geolink/opentracker/docs/OpenTracker 2 - Light Pipe Installation.pdf

# OpenTracker 2

# Light Pipe Installation

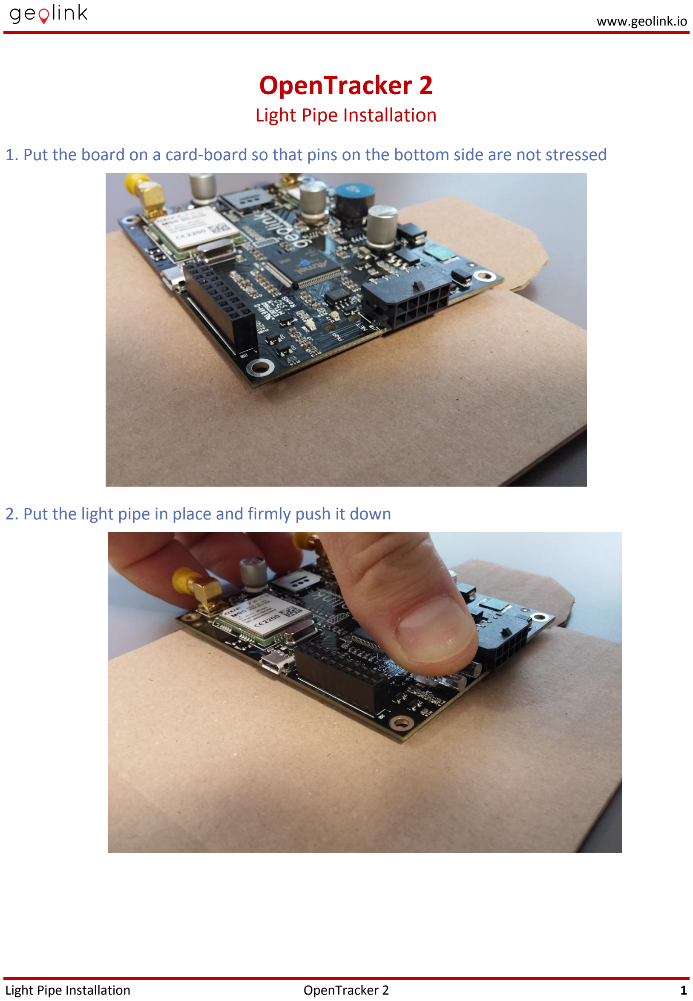
[picture p70: page 1]

### www.geolink.io

Light Pipe Installation | OpenTracker 2 | 1

## 1. Put the board on a card-board so that pins on the bottom side are not stressed

## 2. Put the light pipe in place and firmly push it down

### www.geolink.io

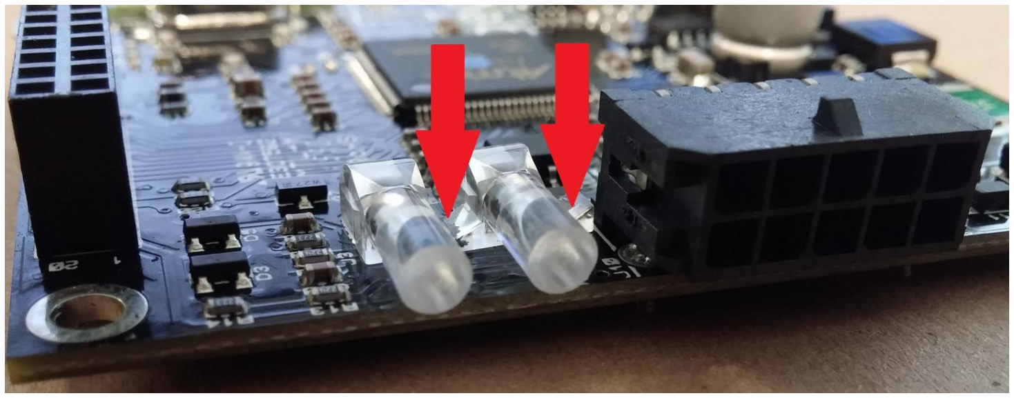
[picture p71: figure]
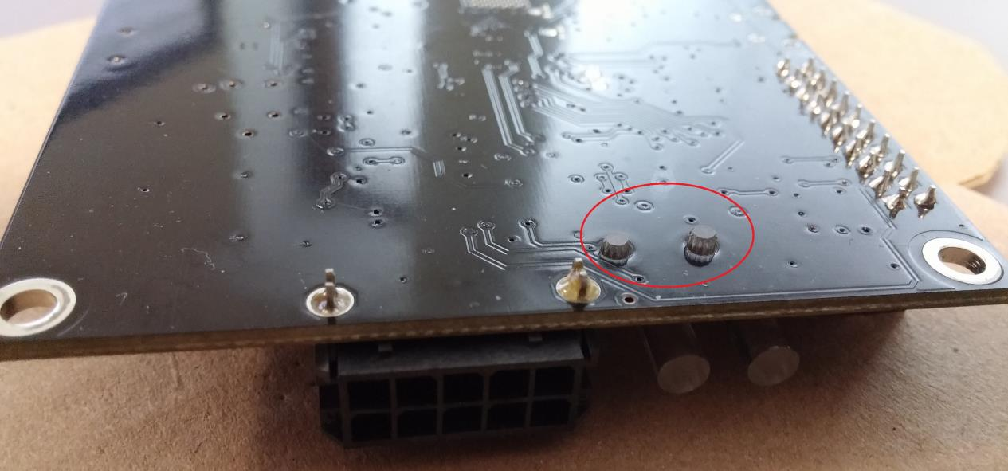
[picture p72: figure]
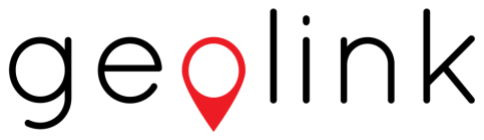
[picture p73: figure]

2 | OpenTracker 2 | Light Pipe Installation
3. If the light pipe is still not in place after pushing with a finger, you can carefully use a flat screwdriver or similar tool to push in correspondence of the small cylinders of the light pipe

## (see red arrows here below)

4. The small cylinders of the light pipe should appear as follows on the bottom side of the

## board

© Geolink all right reserved.

Geolink assumes no responsibility for any errors, which may appear in this manual. Furthermore, Geolink reserves the right to alter the hardware, software, and/or specifications detailed herein at any time without notice, and does not make any commitment to update the information contained herein. Geolink products are not authorized for use as critical components in life support devices or systems. OpenTracker is an open source development board for vehicle tracking applications and any kind of certification/homologation for a final product based on this board is responsibility of the final developer/manufacturer.
