geolink/opentracker/(threads)

Thread 1 (2015-04-20):

Update the PCB fiels and schematics

AnandSingh, 2015-04-20:
Hi

Please update the PCB files and schematics for Opentracker v2 board.

In v2 board the J2 connector is of 20 pins while in schematic and PCB it's showing 22 pins. Please update it's very tough to track the pinouts. I am looking for an uart (EXT_TX , EXT_RX) pin from J2.

Also can you update the old github  https://github.com/TIGAL/OpenTracker repository README for new location of github repository.

Thanks
Anand

AnandSingh, 2015-04-21:
HI
Can anyone help me to setup the EXT_TXD2 , EXT_RXD2.

While using Serial3 for EXT_TXD2, EXT_RXD2 i am only able to receive, but transmit EXT_TXD2 is not working. When I check the voltage level at EXT_TXD2 it's showing ~.97V.

Do I need to connect IO_TO_EXT to 3.3V with EXT_TXD2. Please suggest or help me in this regard.

Thanks
Anand

m4rkw, 2015-07-23:
Hi @AnandSingh I wish I could help but I think you'll need the geolink guys to help you with this.  I think they're swamped with emails but hopefully they'll be able to get back to you at some point.

ppescher, 2015-12-14:
Design files are up-to-date with HW revision 2.2

Closed 2015-12-14.

Thread 3 (2015-05-03):

rooming costs

haegar66, 2015-05-03:
I live near to a country border.
The cost of GPRS are very expensive by international rooming.
I want to turn off the default rooming of the data connection and activate only with an SMS command again (eg in case of theft).
Can this be installed?
greeting
Claus

m4rkw, 2015-07-08:
It should be possible, but probably not easy to implement.  I think what you probably want to do is save the network code for your home network and then detect when it changes, but that's going to involve additional queries to the modem in the main loop.  Also difficult to test as you'd have to roam in order to check that it works.  I'll add it to my someday maybe list :)

m4rkw, 2015-07-18:
@haegar66 Hi, I've just added two new SMS commands which allow you to enable and disable the sending of the data packets.  These are "dataoff" and "dataon".  In both cases it will confirm that the change has been made via sms.  While in "dataoff" mode it will still poll for its location via GPS so you can still use the sms command "locate" to see where the tracker is.  Also be sure to set GSM_SEND_FAILURES_REBOOT to 0 therwise a reboot may occur which will re-enable the data sending.  Also note that if the device gets power cycled for any reason this will also occur.

Hope this helps :)  Mark

haegar66, 2015-08-01:
Am 18.07.2015 um 17:10 schrieb Mark Wadham:
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

Hi,

I have found the solution in theory.

AT+CREG Network Registration
Parameter
0 Disable network registration unsolicited result code
1 Enable network registration unsolicited result code +CREG:
2 Enable network registration unsolicited result code with location
information
0 Not registered, ME is not currently searching a new operator to
register to
1 Registered, home network
2 Not registered, but ME is currently searching a new operator to
register to
3 Registration denied
4 Unknown
5 Registered, roaming

so it could be implemitiert:

tracker.h

   int ROAMING_ON = 0;   //Roaming 0=off 1=on

#define E-Plus_de
//  #define Vodafone_de
//  #define t-mobile_de
//  #define O2_de
//  #define Orange_at
//  #define A1_Mobilkom_Austria_at
//  #define Drei_at
//  #define t-mobile_at
//  #define Bob_at

#ifdef Drei_at
   #define DEFAULT_APN "orange.web"  //default APN
   #define DEFAULT_USER "drei.at"  //default APN user
   #define DEFAULT_PASS ""  //default APN pass
#endif

#ifdef Orange_at
   #define DEFAULT_APN "orange.web"  //default APN
   #define DEFAULT_USER "web"  //default APN user
   #define DEFAULT_PASS "web"  //default APN pass
#endif

#ifdef A1_Mobilkom_Austria_at
   #define DEFAULT_APN "orange.web"  //default APN
   #define DEFAULT_USER "web"  //default APN user
   #define DEFAULT_PASS "web"  //default APN pass
#endif

#ifdef t-mobile_at
   #define DEFAULT_APN "gprsinternet"  //default APN
   #define DEFAULT_USER "t-mobile"  //default APN user
   #define DEFAULT_PASS "tm"  //default APN pass
#endif

#ifdef Bob_at
   #define DEFAULT_APN "bob.at"  //default APN
   #define DEFAULT_USER "data@bob.at"  //default APN user
   #define DEFAULT_PASS "ppp"  //default APN pass
#endif

#ifdef Vodafone_de
   #define DEFAULT_APN "web.vodafone.de"  //default APN
   #define DEFAULT_USER "vodafone"  //default APN user
   #define DEFAULT_PASS "vodafone"  //default APN pass
#endif

#ifdef t-mobile_de
   #define DEFAULT_APN "internet.t-mobile"  //default APN
   #define DEFAULT_USER "tm"  //default APN user
   #define DEFAULT_PASS "tm"  //default APN pass
#endif

#ifdef E-Plus_de
   #define DEFAULT_APN "internet.eplus.de"  //default APN
   #define DEFAULT_USER "eplus"  //default APN user
   #define DEFAULT_PASS "eplus"  //default APN pass
#endif

#ifdef O2_de
   #define DEFAULT_APN "wap.viaginterkorn.de"  //default APN
   #define DEFAULT_USER ""  //default APN user
   #define DEFAULT_PASS ""  //default APN pass
#endif

gsm.ino

void gsm_status_read()
{
   // gsm status

   // 0 Disable network registration unsolicited result code
   // 1 Enable network registration unsolicited result code +CREG: <stat>
   // 2 Enable network registration unsolicited result code with
location information

   // 0 Not registered, ME is not currently searching a new operator to
register to
   // 1 Registered, home network
   // 2 Not registered, but ME is currently searching a new operator to
register to
   // 3 Registration denied
   // 4 Unknown
   // 5 Registered, roaming

   char *status_str;
   int auswahl = 0;

   char *tmp1;
   char *tmp1val;

   debug_print(F("gsm_status() started."));

   //todo check
   gsm_port.print("AT+CREG?");
   gsm_port.print("\r");

   delay(500);
   gsm_get_reply(0);

   //todo check if everything is delivered
   tmp1 = strstr(modem_reply, "AT+CREG: ");
   tmp1 += strlen("+CREG: ");
   tmp1val = strtok(tmp1, "\r");

   //checking how many bytes NON-acked
   status_str = strtok_r(tmp1val, ", ", &tmp1val);
   auswahl = atoi(status_str);

   switch (auswahl) {
     case 0:
       debug_print(F("Disable network registration unsolicited result
code"));
       break;
     case 1:
       debug_print(F("Enable network registration unsolicited result
code +CREG: <stat>"));
       break;
     case 2:
       debug_print(F("Enable network registration unsolicited result
code with location information"));
     default:
       debug_print(F("ERROR"));
   };

   status_str = strtok_r(NULL, ", ", &tmp1val);
   auswahl = atoi(status_str);
   switch (auswahl) {
     case 0:
       debug_print(F("Not registered, ME is not currently searching a
new operator to register to"));
       break;
     case 1:
       debug_print(F("Registered, home network"));
       gsm_status.at_home = 1;
       gsm_status.at_roaming = 0;
       break;
     case 2:
       debug_print(F("Not registered, but ME is currently searching a
new operator to register to"));
     case 3:
       debug_print(F("Registration denied"));
     case 4:
       debug_print(F("Unknown"));
     case 5:
       debug_print(F("Registered, roaming"));
       gsm_status.at_home = 0;
       gsm_status.at_roaming = 1;
     default:
       debug_print(F("ERROR"));
   };

   debug_print(F("gsm_validate_tcp() completed."));

}

sms.ino
tmp = strstr(cmd, "roaming");
      if (tmp!=NULL)
          {
            debug_print(F("sms_cmd_run(): Roaming command detected"));
            if (!ROAMING_ON)
            {
               sms_send_msg("Roaming ON", phone);
               SEND_DATA = 1;
               ROAMING_ON = 1;
            }
            else
             {  sms_send_msg("Roaming OFF", phone);
               SEND_DATA = 1;
               ROAMING_ON = 0;
             }
          }

opentracker_3_0_1.ino

   //gsm status
struct gsm_status_struct {
   int at_home;   //flag for Registered, home network
   int at_roaming; //Flag for Registered, roaming
};

gsm_status_struct gsm_status;

  debug_print(F("Current:"));
    debug_print(data_current);

  gsm_status_read(); // Roaming?

if ((SEND_DATA & gsm_status.at_home ) || (SEND_DATA &
gsm_status.at_roaming & ROAMING_ON)) {
        int i = gsm_send_data();

        if(i != 1)
        {
       //current data not sent, save to sd card
           debug_print(F("Can not send data, saving to flash memory"));
/*
        #ifdef STORAGE
           storage_save_current();   //in case this fails - data is lost
        #endif

*/

Claus Dickert

dimetron, 2015-08-12:
Hi,

Is anyone going to merge above roaming to master or I can do it?

I suggest also to have different GPS timeouts to be set in roaming and potentially
use RAW TCP with compression of several points using polylinealgorithm  https://developers.google.com/maps/documentation/utilities/polylinealgorithm?hl=en

agraciabona, 2016-01-26:
Hi,
I have the opposite problem than haegar66.
I want my tracker contiues working even out of my country but actually does not.
Maybe it is because I modified tracker.h as follows:

#define DEFAULT_APN "orangeworld"
#define DEFAULT_USER "orange"
#define DEFAULT_PASS "orange"

I made this because it is the APN I want to use and my SIM card does not allow SMS (it is cheaper!).

My question is: if I use default settings:

#define DEFAULT_APN "internet"
#define DEFAULT_USER ""
#define DEFAULT_PASS ""

my tracker will connect in every coutry?

I am far away from any border and it's difficult for my to test.
I'll be happy if someone can answer me.

Thanks
Alfredo

bullshit, 2016-01-27:
Hi Alfredo,

if think that your mobile operator blocks GPRS connections outside your country. The APN connections are always the same. This issue treated the possibility to turn off GPRS communication in foreign countries because GPRS roaming is mostly expensive.
>I want to turn off the default roaming of the data connection and activate only with an SMS command again

m4rkw, 2016-01-27:
FWIW I had the same issue using giffgaff in the uk.  Drove to france, tracker mysteriously stopped working.  I think I checked that roaming was enabled on my account before we went, but not 100% sure.  Might go back again sometime this year so if I do I'll check it again and try to figure out why it wasn't working.

agraciabona, 2016-01-27:
I think APN are not allways the same, in Spain APN for Orange is "orangeworld" in France it is "orange". When my vehicle went to France it stopped connecting. I have roaming activated in my SIM card.
I dont know how mobile phones do to switch APN when they travel to other country. I would like to do the same or maybe there is a generic APN which works in every country... if someone can help me...

m4rkw, 2016-01-27:
Maybe there's a mechanism for pushing out APN updates when you roam, that mobile phones are programmed to handle but opentracker is not.  Just a theory.

agraciabona, 2016-01-29:
Please haegar66, maybe you can help me: which APN do you use that provokes your opentracker roam?

agraciabona, 2016-05-13:
Hi,
I want my tracker roams but it doesnt: when it gets out of Spain it stops transmiting.
Anyone can tell which APN should be used to make it roam???
Thanks

ZdenekAster, 2016-05-13:
In Czech Republic GSM operators, APN is some at roaming. But some operators in roaming, send html page with text and button to accept roaming data connect.... Without this click to button roaming not working :-(

m4rkw, 2016-05-14:
@agraciabona I haven't managed to get mine working with roaming yet either, probably because like you say the APN changes.  I think with the current software the only way to get it to work would be to put the sim card into a modern mobile phone, see what the APN gets automatically set to and then configured that in the tracker.

Daniel-dk, 2016-07-18:
you could look at services like Jasper wireles or telit - They are "international network providers

 - they are a bit more expensive than regular operators but have the same APN and manage the roaming for you so the device does not need separate settings per country
We've used Telit before and it worked great ( sub-Saharan Africa )- They need to know how many devices and which countries you want to roam in to give you pricing, so it a bit of a pain, but can provide up to 3 test SIMS.

 - [JASPER wireless ( now Cisco )](https://www.jasper.com/)
 - [Telit ( I think they use Jasper in the background )](http://www.telit.com/products-and-services/iot-connectivity/sim-cards-data-plans/)

Thread 13 (2015-06-26):

imei=D

Fyod, 2015-06-26:
Hi!
I'm testing this library with my Quectel device and unfortunately I always get imei=D.
If I write a program that only shows the imei in the loop, it shows the correct imei every time.
What could be wrong?

Also it seems to me that I'm not getting the GSM date/time because it shows modem reply /[....data....]. Although in debug console I can see the correct GSM date/time a little bit after startup.

I can't use the DueStorage library because the device isn't Due compatible. Is there an alternative to this?

On my server:
imei ... D
key ... testkey
data ... *blank*

Thanks!

Fyod, 2015-06-26:
Dubug:

gsm_get_imei() started
Modem Reply:
AT+GSN

Modem Reply:
865733020106159

Modem Reply:

Modem Reply:
OK

gsm_get_imei() result:
*
gsm_get_imei() completed
setup() completed

TonyArmitstead, 2015-06-29:
IMO the code is currently broken for reading time/date and IMEI from the modem. I had exactly the same problem as you did, but this was just one of many problems the code has. I am currently working through the code re-writing and fixing what _I_ perceive as defects. I currently have a 'working' unit that is reporting position to geolink.io but there are still many other problems to fix and other features _I_ want to add. I am not ready yet to share my changes but can guide you on how to fix the above problem if you are willing to make changes to the code you have.

Neville77, 2015-06-29:
I also have a device which polls quite well to geolink.io but we are trying  to get it send the data to our own server. We are getting a connection to our server but are struggling to get it to send the actual data string to the server. I am interested  in your work  Tony as we wish to add more features  to this if it is reliable code, and we are able to aquire more hardware.

TonyArmitstead, 2015-06-29:
Yes - I also had this problem as well. I changed the code to build a complete HTTP POST message as a single buffer and send it as a single transaction - instead of using the packet chunking code that was already there. This now sends the data fine but there are clear issues of max packet length (which is ok for now) and there are still some timeouts waiting for responses from the modem - still to fix those.

Fyod, 2015-06-29:
Hi Tony,
Thanks for your reply.
I have gotten the data between brackets to send, but as you confirmed, imei and time/date isn't passed on.
It would be great if you could give us some hints to get these sent.

Cheers!

TonyArmitstead, 2015-06-29:
I have created a fork of this project and uploaded all my changes to it.
https://github.com/TonyArmitstead/opentracker.git
You are welcome to clone or just take a look.
NOTE: I am nowhere near finished making my changes yet - dont expect a working system from this repository - yet.

m4rkw, 2015-07-08:
FWIW the original bug of this thread is fixed in master now.  Tony - what other issues are you having?  Let me know and I'll investigate.

m4rkw, 2015-07-08:
Oh also the gps time parsing code should be fixed now too (someone else submitted a patch).  Funny I noticed ages ago that the timestamps from the gps looked a bit weird, didn't even occur to me that the code might be broken.. I just take the timestamp from the server anyway so wasn't really too bothered.

m4rkw, 2015-07-08:
Tried to read your forked commit but so many of the changes are just formatting so it's a bit hard to see the code diffs..

TonyArmitstead, 2015-07-09:
Hi Mark, I am working my way through the code re-implementing a good chunk of it to remove potential bugs (i.e. code issues I see through inspection) and to remove actual bugs. Since I found myself changing lots of code I decided to reformat it all to make it readable *to me* and to get rid of the large sections of commented out code. I know this makes diffs hard, but the code was, *IMO*, very poorly formatted. I will keep pushing my changes into my fork until I am happy that the code basically works - which it still does not.

I am also beginning to suspect problems in the platform integration. I regularly see missing data from the modem which leads me to suspect the uart code is broken. I also see receive data corrupted by transmitted data - especially in the TCP transactions. Both of these show themselves in modem time out messages.

Further, my unit stops sending after a few days - so I suspect time interval issues, but I have not investigated this yet.

Thanks for your interest. Tony

m4rkw, 2015-07-09:
Hi Tony,

It's almost certainly related to changes I made recently in an attempt to optimise the codebase.  I agree it's poorly formatted, I tried to keep to the (bad) formatting when I pushed commits through to make it easier to see the diffs but I completely agree it's a nightmare to work with.  I've been using the new raw sending mode that I added without issue for many weeks, so it seems like the bugs are specific to the http-posting mode.  I'm working through some bugs with someone else in another issue thread on here, once I get through those it will be working in both modes.

What do you mean by 'data missing from the modem'?  I suspect that the other issue where you see received data corrupted by transmitted data is related to this commit:

https://github.com/geolink/opentracker/commit/757fbae5f28b4551c9bbb4f00370fcb03ea586d5

Before that, there were delay(n) statements everywhere in order to wait for the final response from the modem.  I stripped most of these out and wrote some code to detect when the modem had finished responding, but it seems it's buggy.  The last couple of commits I pushed yesterday and today are related to this - some functions where the code is expecting to get a multi-line buffer rather than just the final line from the modem are broken.  You may find the code works better if you check out the version just before this commit, but in any case I'm going to keep on working to fix it.

Mark

Fyod, 2015-07-09:
I'm really happy I'm able to get data sent to my SQL server, so a BIG thank you to you guys taking your time to make this code.
If you need any ideas for the calls and SMS messaging, have a look at www.gsmlib.org. The code is written for SIM908, but most of the AT commands are the same for Quectel calls/messaging. That part of the gsmlib code worked flawlessly for me, but HTTP was a problem.

Cheers!

m4rkw, 2015-07-09:
Glad you've got it working Fyod :)

Fyod, 2015-07-15:
Would anyone happen to know how to add a string after GPS data?
For example: [...gps data...,1.0,2.0,3.0,4.0]
The string alteady has commas and looks like this: 1.0,2.0,3.0,4.0 so I just need to add it in there.

m4rkw, 2015-07-15:
@Fyod see: https://github.com/geolink/opentracker/blob/master/Opentracker_3_0_1/data.ino#L53-L70

m4rkw, 2015-07-23:
HTTP mode is reportedly working now, going to close this issue for now.

Closed 2015-07-23.

Thread 14 (2015-07-07):

Bug in new gsm code. Buffer is overwriting.

ilevans, 2015-07-07:
The new code has a bug in it that causes gsm communication not work. The modem_reply buffer is being overwritten causing required data to be lost.

Using the code to retreive the IMEI number . . .

gsm_get_imei()
calls
gsm_wait_for_reply(1)
which calls
get_gsm_reply() multiple times
which stored data in modem_reply buffer from the befinning.

When control arrives back at gsm_get_imei() the required data is no longer in the buffer.

DEBUG OUTPUT BELOW
========================================
gsm_get_imei() started
Modem Reply:
AT+GSN

Modem Reply:
863071016800770

Modem Reply:

Modem Reply:
OK

gsm_get_imei() result:
.
gsm_get_imei() completed

========================================

m4rkw, 2015-07-08:
now fixed in master, will look at your other issue shortly

Mark

ilevans, 2015-07-08:
Still not picking up the IMEI as it is picking up the incorrect modem response.

Debug Output Below
==========
gsm_get_imei() started
Modem Reply:
AT+GSN

gsm_get_imei() result:
O
gsm_get_imei() completed
gsm_startup_cmd() started
Modem Reply:
863071016800770

Modem Reply:

Modem Reply:
OK

Modem Reply:
AT+QISDE=0

Modem Reply:
OK

Modem Reply:

Modem Reply:
+CFUN: 1

Modem Reply:
AT+QINDI=1

Modem Reply:
OK

==========

m4rkw, 2015-07-08:
Argh sorry, try now?

Mark

ilevans, 2015-07-08:
Getting there.

Now the data being sent is strange.

Debug Output Below
====
collect_gps_data(): fix acquired
Failed checksums:
0
collect_all_data() completed
Current:
�. [,80715,12545209,-26.619892,152.859207,5.67,442.50,162.52,161,5]

====

There also appears to be an issue with retrieving the time from the gsm modem.

Debug Output Below
====
gsm_get_time() started
Modem Reply:
AT+QI
Modem Reply:
DEAC
Modem Reply:
T
AT+CCLK?

Modem Reply:
+CCLK: "08/07/15,12:55:07+00"

Modem Reply:

Modem Reply:
OK

gsm_get_time() result:
�. 0
gsm_get_time() completed

m4rkw, 2015-07-08:
Hi,

I've reverted the earlier patch made to fix the gps date/time.  Please could you try again and post the output?  I'm pretty sure it'll still be broken but I want to rule out additional impact from the earlier patch.

Mark

ilevans, 2015-07-08:
Hi Mark

Sorry for the delay, sleep beckoned and I obliged.

I have included the full debug log this time to assist your efforts as requested.

As you expected, still broken.

Ian
(GMT +10)

Full Debug Output Below
----
gsm_on_off() finished
gsm_on_off() started
gsm_on_off() finished
gsm_restart() completed
gsm_send_at() started
gsm_send_at() completed
gsm_send_at() started
gsm_send_at() completed
gsm_set_pin() started
gsm_set_pin(): PIN is not requered
gsm_set_pin() completed
gsm_get_imei() started
Modem Reply:
AT+GSN

863071016800770

OK

gsm_get_imei() result:
863071016800770
gsm_get_imei() completed
gsm_startup_cmd() started
Modem Reply:
AT+QISDE=0

Modem Reply:
OK

Modem Reply:

Modem Reply:
+CFUN: 1

Modem Reply:
AT+QINDI=1

Modem Reply:
OK

Modem Reply:
AT+CMGF=1

Modem Reply:
OK

gsm_startup_cmd() completed
gsm_set_apn() started
Modem Reply:
AT+QIREGAPP="mdata.net.au","",""

Modem Reply:
OK

Modem Reply:

Modem Reply:
+CPIN: READY

Modem Reply:
AT+QIDNSCFG="8.8.8.8"

Modem Reply:
OK

Modem Reply:
AT+QIDNSIP=1

Modem Reply:
OK

gsm_set_apn() completed
store_get_index() started
store_get_index(): Found log position:
131320
store_get_index() ended
setup() completed
Ignition status:
0
Ignition is ON!
collect_all_data() started
gsm_get_time() started
Modem Reply:
AT+CCLK?

Modem Reply:
+CCLK: "04/01/01,00:00:42+00"

Modem Reply:

Modem Reply:
OK

gsm_get_time() result:
Ñ.
gsm_get_time() completed
$PMTK011,MTKGPS*08
$PMTK010,001*2E
$PMTK011,MTKGPS*08
$PMTK010,002*2D
$GPRMC,235943.058,V,,,,,0.00,0.00,050180,,,N*46
$GPV,05,56,115,,12,56,005,*7F
$GPGSV,4,2,13,29,43,209,37,02,24,132,,21,21,279,,15,11,024,*74
$GPGSV,4,3,13,13,08,057,,10,05,142,,31,04,240,,24,02,352,*77
$GPGSV,4,4,13,193,,,*40
$GLGSV,1,1,00*65
$GPGLL,,,,,191813.096,V,N*76
$GPRMC,191814.096,V,,,,,0.00,0.00,080715,,,N*4D
$GPVTG,0.00,T,,M,0.00,N,0.00,K,N*32
$GPGGA,191814.096,,,,,0,0,,,M,,M,,*43
$GPGSA,A,1,,,,,,,,,,,,,,,*1E
$GPGSV,4,1,13,25,67,268,44,20,59,355,,05,56,115,,12,56,005,*7F
$GPGSV,4,2,13,29,43,209,37,02,24,132,,21,21,279,,15,11,024,*74
$GPGSV,4,3,13,13,08,057,,10,05,142,,31,04,240,,24,02,352,*77
$GPGSV,4,4,13,193,,,*40
$GLGSV,1,1,01,70,10,150,*56
$GPGLL,,,,,191814.096,V,N*71
$GPRMC,191815.096,V,,,,,0.00,0.00,080715,,,N*4C
$GPVTG,0.00,T,,M,0.00,N,0.00,K,N*32
$GPGGA,191815.096,,,,,0,0,,,M,,M,,*42
$GPGSA,A,1,,,,,,,,,,,,,,,*1E
$GPGSV,4,1,13,25,67,268,44,20,59,355,,05,56,115,,12,56,005,*7F
$GPGSV,4,2,13,29,43,209,37,02,24,132,,21,21,279,,15,11,024,*74
$GPGSV,4,3,13,13,08,057,,10,05,142,,31,04,240,,24,02,352,*77
$GPGSV,4,4,13,193,,,*40
$GLGSV,1,1,01,70,10,150,*56
$GPGLL,,,,,191815.096,V,N*70
$GPRMC,191816.096,V,,,,,0.00,0.00,080715,,,N*4F
$GPVTG,0.00,T,,M,0.00,N,0.00,K,N*32
$GPGGA,191816.096,,,,,0,0,,,M,,M,,*41
$GPGSA,A,1,,,,,,,,,,,,,,,*1E
$GPGSV,4,1,13,25,67,268,44,20,59,355,,05,56,115,,12,56,005,*7F
$GPGSV,4,2,13,29,43,209,37,02,24,132,,21,21,279,,15,11,024,*74
$GPGSV,4,3,13,13,08,057,,10,05,142,,31,04,240,,24,02,352,*77
$GPGSV,4,4,13,193,,,*40
$GLGSV,1,1,01,70,10,150,*56
$GPGLL,,,,,191816.096,V,N*73
$GPRMC,191817.096,V,,,,,0.00,0.00,080715,,,N*4E
$GPVTG,0.00,T,,M,0.00,N,0.00,K,N*32
$GPGGA,191817.096,,,,,0,0,,,M,,M,,*40
$GPGSA,A,1,,,,,,,,,,,,,,,*1E
$GPGSV,4,1,13,25,67,268,44,20,59,355,,05,56,115,,12,56,005,*7F
$GPGSV,4,2,13,29,43,209,37,02,24,132,,21,21,279,,15,11,024,*74
$GPGSV,4,3,13,13,08,057,,10,05,142,,31,04,240,,24,02,352,*77
$GPGSV,4,4,13,193,,,*40
$GLGSV,1,1,01,70,10,150,*56
$GPGLL,,,,,191817.096,V,N*72
$GPRMC,191818.096,V,,,,,0.00,0.00,080715,,,N*41
$GPVTG,0.00,T,,M,0.00,N,0.00,K,N*32
$GPGGA,191818.096,,,,,0,0,,,M,,M,,*4F
$GPGSA,A,1,,,,,,,,,,,,,,,*1E
$GPGSV,4,1,13,25,67,268,44,20,59,355,,05,56,115,29,12,56,005,*74
$GPGSV,4,2,13,29,43,209,37,02,24,132,,21,21,279,,15,11,024,*74
$GPGSV,4,3,13,13,08,057,,10,05,142,,31,04,240,,24,02,352,*77
$GPGSV,4,4,13,193,,,*40
$GLGSV,1,1,01,70,10,150,*56
$GPGLL,,,,,191818.096,V,N*7D
$GPRMC,191819.096,V,,,,,0.00,0.00,080715,,,N*40
$GPVTG,0.00,T,,M,0.00,N,0.00,K,N*32
$GPGGA,191819.096,,,,,0,0,,,M,,M,,*4E
$GPGSA,A,1,,,,,,,,,,,,,,,*1E
$GPGSV,4,1,13,25,67,268,44,20,59,355,,05,56,115,28,12,56,005,*75
$GPGSV,4,2,13,29,43,209,37,02,24,132,,21,21,279,,15,11,024,*74
$GPGSV,4,3,13,13,08,057,,10,05,142,,31,04,240,,24,02,352,*77
$GPGSV,4,4,13,193,,,*40
$GLGSV,1,1,01,70,10,150,*56
$GPGLL,,,,,191819.096,V,N*7C
$GPRMC,191820.096,V,,,,,0.00,0.00,080715,,,N*4A
$GPVTG,0.00,T,,M,0.00,N,0.00,K,N*32
$GPGGA,191820.096,,,,,0,0,,,M,,M,,*44
$GPGSA,A,1,,,,,,,,,,,,,,,*1E
$GPGSV,4,1,13,25,67,268,44,20,59,355,,05,56,115,27,12,56,005,*7A
$GPGSV,4,2,13,29,43,209,37,02,24,132,,21,21,279,,15,11,024,*74
$GPGSV,4,3,13,13,08,057,,10,05,142,,31,04,240,,24,02,352,*77
$GPGSV,4,4,13,193,,,*40
$GLGSV,1,1,01,70,10,150,22*56
$GPGLL,,,,,191820.096,V,N*76
$GPRMC,191821.096,V,,,,,0.00,0.00,080715,,,N*4B
$GPVTG,0.00,T,,M,0.00,N,0.00,K,N*32
$GPGGA,191821.096,,,,,0,0,,,M,,M,,*45
$GPGSA,A,1,,,,,,,,,,,,,,,*1E
$GPGSV,4,1,13,25,67,268,44,20,59,355,,05,56,115,28,12,56,005,*75
$GPGSV,4,2,13,29,43,209,37,02,24,132,,21,21,279,,15,11,024,*74
$GPGSV,4,3,13,13,08,057,,10,05,142,,31,04,240,,24,02,352,*77
$GPGSV,4,4,13,193,,,*40
$GLGSV,1,1,01,70,10,150,24*50
$GPGLL,,,,,191821.096,V,N*77
$GPRMC,191822.096,V,,,,,0.00,0.00,080715,,,N*48
$GPVTG,0.00,T,,M,0.00,N,0.00,K,N*32
$GPGGA,191822.096,,,,,0,0,,,M,,M,,*46
$GPGSA,A,1,,,,,,,,,,,,,,,*1E
$GPGSV,4,1,13,25,67,268,44,20,59,355,,05,56,115,28,12,56,005,*75
$GPGSV,4,2,13,29,43,209,37,02,24,132,,21,21,279,,15,11,024,*74
$GPGSV,4,3,13,13,08,057,,10,05,142,,31,04,240,,24,02,352,*77
$GPGSV,4,4,13,193,,,*40
$GLGSV,1,1,01,70,10,150,26*52
$GPGLL,,,,,191822.096,V,N*74
$GPRMC,191823.096,V,,,,,0.00,0.00,080715,,,N*49
$GPVTG,0.00,T,,M,0.00,N,0.00,K,N*32
$GPGGA,191823.096,,,,,0,0,,,M,,M,,*47
$GPGSA,A,1,,,,,,,,,,,,,,,*1E
$GPGSV,4,1,13,25,67,268,44,20,59,355,,05,56,115,26,12,56,005,*7B
$GPGSV,4,2,13,29,43,209,37,02,24,132,,21,21,279,,15,11,024,*74
$GPGSV,4,3,13,13,08,057,,10,05,142,,31,04,240,,24,02,352,*77
$GPGSV,4,4,13,193,,,*40
$GLGSV,1,1,01,70,10,150,25*51
$GPGLL,,,,,191823.096,V,N*75
$GPRMC,191824.096,V,,,,,0.00,0.00,080715,,,N*4E
$GPVTG,0.00,T,,M,0.00,N,0.00,K,N*32
$GPGGA,191824.096,,,,,0,0,,,M,,M,,*40
$GPGSA,A,1,,,,,,,,,,,,,,,*1E
$GPGSV,4,1,13,25,67,268,43,20,59,355,,05,56,115,26,12,56,005,*7C
$GPGSV,4,2,13,29,43,209,37,02,24,132,28,21,21,279,,15,11,024,*7E
$GPGSV,4,3,13,13,08,057,,10,05,142,,31,04,240,,24,02,352,*77
$GPGSV,4,4,13,193,,,*40
$GLGSV,1,1,01,70,10,150,25*51
$GPGLL,,,,,191824.096,V,N*72
$GPRMC,191825.096,V,,,,,0.00,0.00,080715,,,N*4F
$GPVTG,0.00,T,,M,0.00,N,0.00,K,N*32
$GPGGA,191825.096,,,,,0,0,,,M,,M,,*41
$GPGSA,A,1,,,,,,,,,,,,,,,*1E
$GPGSV,4,1,13,25,67,268,43,20,59,355,,05,56,115,25,12,56,005,*7F
$GPGSV,4,2,13,29,43,209,37,02,24,132,28,21,21,279,,15,11,024,*7E
$GPGSV,4,3,13,13,08,057,,10,05,142,,31,04,240,,24,02,352,*77
$GPGSV,4,4,13,193,,,*40
$GLGSV,1,1,01,70,10,150,23*57
$GPGLL,,,,,191825.096,V,N*73
Failed checksums:
1
collect_gps_data(): fix not acquired, given up.
collect_all_data() completed
Current:
Ñ. []

gsm_send_at() started
gsm_send_at() completed
Modem Reply:

Modem Reply:
Call Ready

Modem Reply:
AT
AT

Modem Reply:
OK

gsm_disconnect() started
Modem Reply:

Modem Reply:
OK

Modem Reply:
AT+QIDEACT

Modem Reply:
DEACT OK

gsm_disconnect(): DEACT OK found
gsm_disconnect() completed
GPRS deactivated.
gsm_connect() started
Connecting to remote server...
0
Modem Reply:
AT+QIOPEN="TCP","updates.geolink.io","80"

Modem Reply:
OK

Modem Reply:

Modem Reply:
CONNECT OK

Connected to remote server:
updates.geolink.io
gsm_connect() completed
gsm_send_http(): sending data.
Ñ. []

gsm_send_http(): Length of data packet:
45
gsm_send_http(): Length of header packet:
170
Modem Reply:
AT+QISEND=170

Modem Reply:
>
gsm_validate_tcp() started.
Modem Reply:

Modem Reply:
SEND OK

gsm_validate_tcp() data delivered.
gsm_validate_tcp() completed.
gsm_send_http(): Sending IMEI and Key
Modem Reply:
AT+QISEND=39

Modem Reply:
>
Modem Reply:

Modem Reply:
SEND OK

gsm_send_http(): Sending body
gsm_send_http(): Body packet size:
6
gsm_send_http(): Sending data chunk:
0
gsm_send_http(): chunk length:
6
Modem Reply:
AT+QISEND=6

Modem Reply:
>
gsm_send_http(): data sent.
Modem Reply:

Modem Reply:
SEND OK

parse_receive_reply() started
Modem Reply:
AT+QIRD=0,1,0,100

Modem Reply:
OK

Modem Reply:
AT+QIRD=0,1,0,100

Modem Reply:
OK

Modem Reply:
AT+QIRD=0,1,0,100

Modem Reply:
OK

Modem Reply:
AT+QIRD=0,1,0,100

Modem Reply:
OK

Modem Reply:

Modem Reply:
+QIRDI: 0,1,0

Modem Reply:
AT+QIRD=0,1,0,100

Modem Reply:
+QIRD: 78.46.45.61:80,TCP,100

Modem Reply:
HTTP/1.1 200 OK

Modem Reply:
Server: nginx/1.8.0

Modem Reply:
Date: Wed, 08 Jul 2015
Warning: timed out waiting for last modem reply
Modem Reply:
AT+QIRD=0,1,0,100

Modem Reply:
+QIRD: 78.46.45.61:80,TCP,49

Modem Reply:
Connection: close

Modem Reply:

Modem Reply:
#t:15/07/08,19:18:29+00

Modem Reply:
#eof

Modem Reply:
OK

Modem Reply:

Modem Reply:
0, CLOSED

Modem Reply:

Modem Reply:
0, CLOSAT+QIRD=0,1,0,100

Modem Reply:
ERROR

No more data available.
Data was not received by the server.
parse_cmd() started
Received commands:
�7
parse_cmd() completed
parse_receive_reply() completed
gsm_disconnect() started
gsm_disconnect(): DEACT OK not found.
gsm_disconnect() completed
Can not send data, saving to flash memory
Ignition status:
0
Ignition is ON!
collect_all_data() started
gsm_get_time() started
Modem Reply:
AT+QIDEACT

Modem Reply:
AT+CCLK?

Modem Reply:
+CCLK: "04/01/01,00:01:10+00"

Modem Reply:

Modem Reply:
OK

gsm_get_time() result:
Ñ.
gsm_get_time() completed
$GPRMC,191826.096,V,,,,,0.00,0.00,080715,,,N*4C
$GPVTG,0.00,T,,M,0.00,N,0.00,K,N*32
$GPGGA,191826.096,,,,,0,0,,,M,,M,,*42
$G$GPRMC,191841.089,V,,,,,0.06,356.58,080715,,,N*48
$GPVTG,356.58,T,,M,0.06,N,0.12,K,N*3A
$GPGGA,191841.089,,,,,0,0,,,M,,M,,*4D
$GPGSA,A,1,,,,,,,,,,,,,,,*1E
$GPGSV,4,1,13,25,67,268,42,20,60,355,,05,56,115,31,12,56,005,28*7B
$GPGSV,4,2,13,29,43,209,33,02,24,132,29,21,22,279,27,15,11,024,*7D
$GPGSV,4,3,13,13,08,057,,10,05,142,,31,04,240,,24,02,352,*77
$GPGSV,4,4,13,193,,,25*47
$GLGSV,1,1,02,87,28,216,35,70,10,150,21*60
$GPGLL,,,,,191841.089,V,N*7F
$GNRMC,191842.089,V,,,,,0.04,356.58,080715,,,N*57
$GPVTG,356.58,T,,M,0.04,N,0.07,K,N*3C
$GPGGA,191842.089,,,,,0,0,,,M,,M,,*4E
$GNGSA,A,1,,,,,,,,,,,,,,,*00
$GNGSA,A,1,,,,,,,,,,,,,,,*00
$GPGSV,4,1,13,25,67,268,42,20,60,355,,05,56,115,32,12,56,005,29*79
$GPGSV,4,2,13,29,43,209,33,02,24,132,29,21,22,279,27,15,11,024,*7D
$GPGSV,4,3,13,13,08,057,,10,05,142,,31,04,240,,24,02,352,*77
$GPGSV,4,4,13,193,,,24*46
$GLGSV,1,1,02,87,28,216,35,70,10,150,21*60
$GNGLL,,,,,191842.089,V,N*62
$GNRMC,191843.089,V,,,,,0.03,356.58,080715,,,N*51
$GPVTG,356.58,T,,M,0.03,N,0.06,K,N*3A
$GPGGA,191843.089,,,,,0,0,,,M,,M,,*4F
$GNGSA,A,1,,,,,,,,,,,,,,,*00
$GNGSA,A,1,,,,,,,,,,,,,,,*00
$GPGSV,4,1,13,25,67,268,42,20,60,355,,05,56,115,33,12,56,005,29*78
$GPGSV,4,2,13,29,44,209,32,02,24,132,29,21,22,279,26,15,11,024,*7A
$GPGSV,4,3,13,13,08,057,,10,05,142,,31,04,240,,24,02,352,*77
$GPGSV,4,4,13,193,,,25*47
$GLGSV,1,1,02,87,28,216,36,70,10,150,21*63
$GNGLL,,,,,191843.089,V,N*63
$GNRMC,191844.089,V,,,,,0.10,356.58,080715,,,N*54
$GPVTG,356.58,T,,M,0.10,N,0.19,K,N*36
$GPGGA,191844.089,,,,,0,0,,,M,,M,,*48
$GNGSA,A,1,,,,,,,,,,,,,,,*00
$GNGSA,A,1,,,,,,,,,,,,,,,*00
$GPGSV,4,1,13,25,67,268,42,20,60,355,,05,56,115,33,12,56,005,30*70
$GPGSV,4,2,13,29,44,209,32,02,24,132,29,21,22,279,26,15,11,024,*7A
$GPGSV,4,3,13,13,08,057,,10,05,142,,31,04,240,,24,02,352,*77
$GPGSV,4,4,13,193,,,27*45
$GLGSV,1,1,03,87,28,216,36,70,10,150,20,75,01,352,*54
$GNGLL,,,,,191844.089,V,N*64
$GNRMC,191845.089,V,,,,,0.10,356.58,080715,,,N*55
$GPVTG,356.58,T,,M,0.10,N,0.19,K,N*36
$GPGGA,191845.089,,,,,0,0,,,M,,M,,*49
$GNGSA,A,1,,,,,,,,,,,,,,,*00
$GNGSA,A,1,,,,,,,,,,,,,,,*00
$GPGSV,4,1,13,25,67,268,42,20,60,355,,05,56,115,33,12,56,005,28*79
$GPGSV,4,2,13,29,44,209,32,02,24,132,28,21,22,279,26,15,11,024,*7B
$GPGSV,4,3,13,13,08,057,,10,05,142,,31,04,240,,24,02,352,*77
$GPGSV,4,4,13,193,,,27*45
$GLGSV,1,1,03,87,28,216,36,70,10,150,20,75,01,352,*54
$GNGLL,,,,,191845.089,V,N*65
$GNRMC,191846.089,V,,,,,0.11,356.58,080715,,,N*57
$GPVTG,356.58,T,,M,0.11,N,0.20,K,N*3D
$GPGGA,191846.089,,,,,0,0,,,M,,M,,*4A
$GNGSA,A,1,,,,,,,,,,,,,,,*00
$GNGSA,A,1,,,,,,,,,,,,,,,*00
$GPGSV,4,1,13,25,67,268,42,20,60,355,24,05,56,115,33,12,56,005,28*7F
$GPGSV,4,2,13,29,44,209,31,02,24,132,28,21,22,279,26,15,11,024,*78
$GPGSV,4,3,13,13,08,057,,10,05,142,,31,04,241,,24,02,352,*76
$GPGSV,4,4,13,193,,,27*45
$GLGSV,1,1,03,87,28,216,35,70,10,150,19,75,01,352,*5D
$GNGLL,,,,,191846.089,V,N*66
$GNRMC,191847.089,V,,,,,0.05,356.58,080715,,,N*53
$GPVTG,356.58,T,,M,0.05,N,0.09,K,N*33
$GPGGA,191847.089,,,,,0,0,,,M,,M,,*4B
$GNGSA,A,1,,,,,,,,,,,,,,,*00
$GNGSA,A,1,,,,,,,,,,,,,,,*00
$GPGSV,4,1,13,25,67,268,43,20,60,355,25,05,56,115,33,12,56,005,28*7F
$GPGSV,4,2,13,29,44,209,31,02,24,132,28,21,22,279,25,15,11,024,*7B
$GPGSV,4,3,13,13,08,057,,10,05,142,,31,04,241,,24,02,352,*76
$GPGSV,4,4,13,193,,,27*45
$GLGSV,1,1,03,87,28,216,34,70,10,150,19,75,01,352,*5C
$GNGLL,,,,,191847.089,V,N*67
$GNRMC,191848.089,V,,,,,0.05,356.58,080715,,,N*5C
$GPVTG,356.58,T,,M,0.05,N,0.09,K,N*33
$GPGGA,191848.089,,,,,0,0,,,M,,M,,*44
$GNGSA,A,1,,,,,,,,,,,,,,,*00
$GNGSA,A,1,,,,,,,,,,,,,,,*00
$GPGSV,4,1,13,25,67,268,43,20,60,355,23,05,56,115,33,12,56,005,28*79
$GPGSV,4,2,13,29,44,209,31,02,24,132,28,21,22,279,24,15,11,024,*7A
$GPGSV,4,3,13,13,08,057,,10,05,142,,31,04,241,,24,02,352,*76
$GPGSV,4,4,13,193,,,27*45
$GLGSV,1,1,04,87,28,216,34,76,28,307,,70,10,150,19,75,01,352,*64
$GNGLL,,,,,191848.089,V,N*68
$GNRMC,191849.089,V,,,,,0.15,356.58,080715,,,N*5C
$GPVTG,356.58,T,,M,0.15,N,0.27,K,N*3E
$GPGGA,191849.089,,,,,0,0,,,M,,M,,*45
$GNGSA,A,1,,,,,,,,,,,,,,,*00
$GNGSA,A,1,,,,,,,,,,,,,,,*00
$GPGSV,4,1,14,25,67,268,43,20,60,355,24,50,57,342,,05,56,115,33*74
$GPGSV,4,2,14,12,56,005,28,29,44,209,31,02,24,132,28,21,22,279,24*70
$GPGSV,4,3,14,15,11,024,,13,08,057,,10,05,142,,31,04,241,*73
$GPGSV,4,4,14,24,02,352,,193,,,27*72
$GLGSV,1,1,04,87,28,216,33,76,28,307,,70,10,150,18,75,01,352,*62
$GNGLL,,,,,191849.089,V,N*69
$GNRMC,191850.089,V,,,,,0.02,356.58,080715,,,N*52
$GPVTG,356.58,T,,M,0.02,N,0.05,K,N*38
$GPGGA,191850.089,,,,,0,0,,,M,,M,,*4D
$GNGSA,A,1,,,,,,,,,,,,,,,*00
$GNGSA,A,1,,,,,,,,,,,,,,,*00
$GPGSV,4,1,14,25,67,268,43,20,60,355,22,50,57,342,,05,56,115,33*72
$GPGSV,4,2,14,12,56,005,28,29,44,209,31,02,24,132,27,21,22,279,24*7F
$GPGSV,4,3,14,15,11,024,,13,08,057,,10,05,142,,31,04,241,*73
$GPGSV,4,4,14,24,02,352,,193,,,27*72
$GLGSV,1,1,04,87,28,216,33,76,28,307,,70,10,150,16,75,01,352,*6C
$GNGLL,,,,,191850.089,V,N*61
$GNRMC,191851.089,V,,,,,0.17,356.58,080715,,,N*57
$GPVTG,356.58,T,,M,0.17,N,0.31,K,N*3B
$GPGGA,191851.089,,,,,0,0,,,M,,M,,*4C
$GNGSA,A,1,,,,,,,,,,,,,,,*00
$GNGSA,A,1,,,,,,,,,,,,,,,*00
$GPGSV,4,1,14,25,67,268,43,20,60,355,24,50,57,342,,05,56,115,33*74
$GPGSV,4,2,14,12,56,005,29,29,44,209,31,02,24,132,26,21,22,279,24*7F
$GPGSV,4,3,14,15,11,024,,13,08,057,18,10,05,142,,31,04,241,*7A
$GPGSV,4,4,14,24,02,352,,193,,,27*72
$GLGSV,1,1,04,87,28,216,33,76,28,307,,70,10,150,15,75,01,352,*6F
$GNGLL,,,,,191851.089,V,N*60
$GNRMC,191852.089,V,,,,,0.17,356.58,080715,,,N*54
$GPVTG,356.58,T,,M,0.17,N,0.32,K,N*38
$GPGGA,191852.089,,,,,0,0,,,M,,M,,*4F
$GNGSA,A,1,,,,,,,,,,,,,,,*00
$GNGSA,A,1,,,,,,,,,,,,,,,*00
$GPGSV,4,1,14,25,67,268,43,20,60,355,23,50,57,342,,05,56,115,33*73
$GPGSV,4,2,14,12,56,005,30,29,44,209,30,02,24,132,26,21,22,279,24*76
$GPGSV,4,3,14,15,11,024,,13,08,057,21,10,05,142,,31,04,241,*70
$GPGSV,4,4,14,24,02,352,,193,,,27*72
$GLGSV,2,1,05,87,28,216,33,76,28,307,,77,26,246,,70,10,150,15*6E
$GLGSV,2,2,05,75,01,352,*57
$GNGLL,,,,,191852.089,V,N*63
$GNRMC,191853.089,V,,,,,0.20,356.58,080715,,,N*51
$GPVTG,356.58,T,,M,0.20,N,0.37,K,N*39
$GPGGA,191853.089,,,,,0,0,,,M,,M,,*4E
$GNGSA,A,1,,,,,,,,,,,,,,,*00
$GNGSA,A,1,,,,,,,,,,,,,,,*00
$GPGSV,4,1,14,25,67,268,43,20,60,355,22,50,57,342,,05,56,115,33*72
$GPGSV,4,2,14,12,56,005,31,29,44,209,30,02,24,132,25,21,22,279,24*74
$GPGSV,4,3,14,15,11,024,,13,08,057,21,10,05,142,,31,04,241,*70
$GPGSV,4,4,14,24,02,352,,193,,,28*7D
$GLGSV,2,1,05,87,28,216,32,76,28,307,,77,26,246,,70,10,150,16*6C
$GLGSV,2,2,05,75,01,352,*57
$GNGLL,,,,,191853.089Failed checksums:
1
collect_gps_data(): fix not acquired, given up.
collect_all_data() completed
Current:
Ñ. []

gsm_send_at() started
gsm_send_at() completed
Modem Reply:

Modem Reply:
DEACT OK

gsm_disconnect() started
Modem Reply:
AT
AT

Modem Reply:
OK

Modem Reply:

Modem Reply:
OK

Modem Reply:
AT+QIDEACT

Modem Reply:
DEACT OK

gsm_disconnect(): DEACT OK found
gsm_disconnect() completed
GPRS deactivated.
gsm_connect() started
Connecting to remote server...
0
Modem Reply:
AT+QIOPEN="TCP","updates.geolink.io","80"

Modem Reply:
OK

Modem Reply:

Modem Reply:
CONNECT OK

Connected to remote server:
updates.geolink.io
gsm_connect() completed
gsm_send_http(): sending data.
Ñ. []

gsm_send_http(): Length of data packet:
45
gsm_send_http(): Length of header packet:
170
Modem Reply:
AT+QISEND=170

Modem Reply:
>
gsm_validate_tcp() started.
Modem Reply:

Modem Reply:
SEND OK

gsm_validate_tcp() data delivered.
gsm_validate_tcp() completed.
gsm_send_http(): Sending IMEI and Key
Modem Reply:
AT+QISEND=39

Modem Reply:
>
Modem Reply:

Modem Reply:
SEND OK

gsm_send_http(): Sending body
gsm_send_http(): Body packet size:
6
gsm_send_http(): Sending data chunk:
0
gsm_send_http(): chunk length:
6
Modem Reply:
AT+QISEND=6

Modem Reply:
>
gsm_send_http(): data sent.
Modem Reply:

Modem Reply:
SEND OK

parse_receive_reply() started
Modem Reply:
AT+QIRD=0,1,0,100

Modem Reply:
OK

Modem Reply:
AT+QIRD=0,1,0,100

Modem Reply:
OK

Modem Reply:
AT+QIRD=0,1,0,100

Modem Reply:
OK

Modem Reply:
AT+QIRD=0,1,0,100

Modem Reply:
OK

Modem Reply:

Modem Reply:
+QIRDI: 0,1,0

Modem Reply:
AT+QIRD=0,1,0,100

Modem Reply:
+QIRD: 78.46.45.61:80,TCP,100

Modem Reply:
HTTP/1.1 200 OK

Modem Reply:
Server: nginx/1.8.0

Modem Reply:
Date: Wed, 08 Jul 2015
Warning: timed out waiting for last modem reply
Modem Reply:
AT+QIRD=0,1,0,100

Modem Reply:
+QIRD: 78.46.45.61:80,TCP,49

Modem Reply:
Connection: close

Modem Reply:

Modem Reply:
#t:15/07/08,19:18:57+00

Modem Reply:
#eof

Modem Reply:
OK

Modem Reply:

Modem Reply:
0, CLOSED

Modem Reply:

Modem Reply:
0, CLOSAT+QIRD=0,1,0,100

Modem Reply:
ERROR

No more data available.
Data was not received by the server.
parse_cmd() started
Received commands:
�7
parse_cmd() completed
parse_receive_reply() completed
gsm_disconnect() started
gsm_disconnect(): DEACT OK not found.
gsm_disconnect() completed
Can not send data, saving to flash memory
Ignition status:
0
Ignition is ON!
collect_all_data() started
gsm_get_time() started
Modem Reply:
AT+QI
Modem Reply:
DEACT

Modem Reply:
AT+CCLK?

Modem Reply:
+CCLK: "04/01/01,00:01:37+00"

Modem Reply:

Modem Reply:
OK

gsm_get_time() result:
Ñ.
gsm_get_time() completed
,V,N*62
$GNRMC,191854.089,V,,,,,0.23,356.58,080715,,,N*55
$GPVTG,356.58,T,,M,0.23,N,0.43,K,N*39
$GPGGA,191854.089,,,,,0,0,,,$GPGSV,4,3,14,15,11,024,,13,08,057,19,10,05,142,,31,04,241,*7B
$GPGSV,4,4,14,24,02,352,,193,,,29*7C
$GLGSV,2,1,05,87,28,216,30,76,28,307,,77,26,246,32,70,10,150,19*60
$GLGSV,2,2,05,75,01,352,*57
$GNGLL,2637.1894,S,15251.5542,E,191908.000,A,A*52
$GNRMC,191909.000,A,2637.1891,S,15251.5547,E,0.41,356.58,080715,,,A*67
Invalid altitude, retrying.

$GPVTG,356.58,T,,M,0.41,N,0.76,K,A*34
$GPGGA,191909.000,2637.1891,S,15251.5547,E,1,7,1.20,365.5,M,39.7,M,,*44
GPS fix received.
Data is current.
Current time set from GPS time:
08/07/15,19:19:09+00
gsm_set_time() started
Modem Reply:

Modem Reply:
DEACT OK

gsm_set_time() completed

GPS already available, breaking
collect_gps_data(): fix acquired
Failed checksums:
1
collect_all_data() completed
Current:
Ñ. [,80715,19190900,-26.619818,152.859238,0.76,365.50,356.58,120,7]

gsm_send_at() started
gsm_send_at() completed
Modem Reply:
AT+CCLK="08/07/15,19:19:09+00"

Modem Reply:
OK

gsm_disconnect() started
Modem Reply:
AT
AT

Modem Reply:
OK

Modem Reply:

Modem Reply:
OK

Modem Reply:
AT+QIDEACT

Modem Reply:
DEACT OK

gsm_disconnect(): DEACT OK found
gsm_disconnect() completed
GPRS deactivated.
gsm_connect() started
Connecting to remote server...
0
Modem Reply:
AT+QIOPEN="TCP","updates.geolink.io","80"

Modem Reply:
OK

Modem Reply:

Modem Reply:
CONNECT OK

Connected to remote server:
updates.geolink.io
gsm_connect() completed
gsm_send_http(): sending data.
Ñ. [,80715,19190900,-26.619818,152.859238,0.76,365.50,356.58,120,7]

gsm_send_http(): Length of data packet:
107
gsm_send_http(): Length of header packet:
171
Modem Reply:
AT+QISEND=171

Modem Reply:
>
gsm_validate_tcp() started.
Modem Reply:

Modem Reply:
SEND OK

gsm_validate_tcp() data delivered.
gsm_validate_tcp() completed.
gsm_send_http(): Sending IMEI and Key
Modem Reply:
AT+QISEND=39

Modem Reply:
>
Modem Reply:

Modem Reply:
SEND OK

gsm_send_http(): Sending body
gsm_send_http(): Body packet size:
68
gsm_send_http(): Sending data chunk:
0
gsm_send_http(): chunk length:
68
Modem Reply:
AT+QISEND=68

Modem Reply:
>
gsm_send_http(): data sent.
Modem Reply:

Modem Reply:
SEND OK

parse_receive_reply() started
Modem Reply:
AT+QIRD=0,1,0,100

Modem Reply:
OK

Modem Reply:
AT+QIRD=0,1,0,100

Modem Reply:
OK

Modem Reply:
AT+QIRD=0,1,0,100

Modem Reply:
OK

Modem Reply:
AT+QIRD=0,1,0,100

Modem Reply:
OK

Modem Reply:
AT+QIRD=0,1,0,100

Modem Reply:
OK

Modem Reply:
AT+QIRD=0,1,0,100

Modem Reply:
OK

Modem Reply:
AT+QIRD=0,1,0,100

Modem Reply:
OK

Modem Reply:
AT+QIRD=0,1,0,100

Modem Reply:
OK

Modem Reply:
AT+QIRD=0,1,0,100

Modem Reply:
+QIRD: 78.46.45.61:80,TCP,100

Modem Reply:
HTTP/1.1 200 OK

Modem Reply:
Server: nginx/1.8.0

Modem Reply:
Date: Wed, 08 Jul 2015 19:19:14 GMT

Modem Reply:
C
Warning: timed out waiting for last modem reply
Modem Reply:
AT+QIRD=0,1,0,100

Modem Reply:
+QIRD: 78.46.45.61:80,TCP,49

Modem Reply:
Connection: close

Modem Reply:

Modem Reply:
#t:15/07/08,19:19:14+00

Modem Reply:
#eof

Modem Reply:
OK

Modem Reply:

Modem Reply:
0, CLOSED

Modem Reply:

Modem Reply:
0, CLOSAT+QIRD=0,1,0,100

Modem Reply:
ERROR

No more data available.
Data was not received by the server.
parse_cmd() started
Received commands:
�7
parse_cmd() completed
parse_receive_reply() completed
gsm_disconnect() started
gsm_disconnect(): DEACT OK not found.
gsm_disconnect() completed
Can not send data, saving to flash memory
Ignition status:
0
Ignition is ON!
collect_all_data() started
gsm_get_time() started
Modem Reply:
AT+QIDEACT

Modem Reply:
AT+CCLK?

Modem Reply:
+CCLK: "08/07/15,19:19:24+00"

Modem Reply:

Modem Reply:
OK

gsm_get_time() result:
Ñ. 0
gsm_get_time() completed
$GNGSA,A,3,29,25,05,13,193,12,,,,,,,1.48,1.20,0.87*2E
$GNGSA,A,3,87,,,,,,,,,,,,1.48,1.20,0.87*12
$GPGSV,4,1,14,25,67,268,43,,5,56,115,25*75
$GPGSV,4,2,14,12,56,005,30,29,44,209,33,02,24,132,24,21,22,279,*71
$GPGSV,4,3,14,15,11,024,,13,08,057,20,10,05,142,19,31,04,241,*79
$GPGSV,4,4,14,24,02,352,,193,,,26*73
$GLGSV,2,1,05,87,28,216,32,76,28,307,,77,26,246,33,70,10,150,24*6D
$GLGSV,2,2,05,75,01,352,*57
$GNGLL,2637.1875,S,15251.5583,E,191925.000,A,A*5F
$GNRMC,191926.000,A,2637.1877,S,15251.5583,E,0.03,356.58,080715,,,A*6C
GPS fix received.
Data is current.
Current time set from GPS time:
08/07/15,19:19:26+00
gsm_set_time() started
Modem Reply:

Modem Reply:
DEACT OK

gsm_set_time() completed

GPS already available, breaking
collect_gps_data(): fix acquired
Failed checksums:
2
collect_all_data() completed
Current:
Ñ. 0[,80715,19192600,-26.619795,152.859299,0.06,365.50,356.58,120,7]

gsm_send_at() started
gsm_send_at() completed
Modem Reply:
AT+CCLK="08/07/15,19:19:26+00"

Modem Reply:
OK

gsm_disconnect() started
Modem Reply:
AT
AT

Modem Reply:
OK

Modem Reply:

Modem Reply:
OK

Modem Reply:
AT+QIDEACT

Modem Reply:
DEACT OK

gsm_disconnect(): DEACT OK found
gsm_disconnect() completed
GPRS deactivated.
gsm_connect() started
Connecting to remote server...
0
Modem Reply:
AT+QIOPEN="TCP","updates.geolink.io","80"

Modem Reply:
OK

Modem Reply:

Modem Reply:
CONNECT OK

Connected to remote server:
updates.geolink.io
gsm_connect() completed
gsm_send_http(): sending data.
Ñ. 0[,80715,19192600,-26.619795,152.859299,0.06,365.50,356.58,120,7]

gsm_send_http(): Length of data packet:
108
gsm_send_http(): Length of header packet:
171
Modem Reply:
AT+QISEND=171

Modem Reply:
>
gsm_validate_tcp() started.
Modem Reply:

Modem Reply:
SEND OK

gsm_validate_tcp() data delivered.
gsm_validate_tcp() completed.
gsm_send_http(): Sending IMEI and Key
Modem Reply:
AT+QISEND=39

Modem Reply:
>
Modem Reply:

Modem Reply:
SEND OK

gsm_send_http(): Sending body
gsm_send_http(): Body packet size:
69
gsm_send_http(): Sending data chunk:
0
gsm_send_http(): chunk length:
69
Modem Reply:
AT+QISEND=69

Modem Reply:
>
gsm_send_http(): data sent.
Modem Reply:

Modem Reply:
SEND OK

parse_receive_reply() started
Modem Reply:
AT+QIRD=0,1,0,100

Modem Reply:
OK

Modem Reply:
AT+QIRD=0,1,0,100

Modem Reply:
OK

Modem Reply:
AT+QIRD=0,1,0,100

Modem Reply:
OK

Modem Reply:
AT+QIRD=0,1,0,100

Modem Reply:
OK

Modem Reply:
AT+QIRD=0,1,0,100

Modem Reply:
OK

Modem Reply:
AT+QIRD=0,1,0,100

Modem Reply:
OK

Modem Reply:
AT+QIRD=0,1,0,100

Modem Reply:
OK

Modem Reply:
AT+QIRD=0,1,0,100

Modem Reply:
OK

Modem Reply:
AT+QIRD=0,1,0,100

Modem Reply:
+QIRD: 78.46.45.61:80,TCP,100

Modem Reply:
HTTP/1.1 200 OK

Modem Reply:
Server: nginx/1.8.0

Modem Reply:
Date: Wed, 08 Jul 2015 19:19:31 GMT

Modem Reply:
C

m4rkw, 2015-07-09:
Thanks, it's looking quite broken there, seems like nulls in the start of the data packet.  Just pushed a fix that should correct the gsm time collection, please could you try that and re-post the output?  I think this is going to be a fairly slow debug cycle but we'll get there :)

Mark

ilevans, 2015-07-09:
I re-loaded my working version of the software and captured a working log for reference. I have included the Broken and Working log file.

The data uploading is incorrect.

**Working from Pre Remove Delay Version with my date/time parsing.**
15/07/09,07:22:39+0[90715,7224800,-26.619829,152.859177,0.37,412.10,206.77,80,12]

**Not working from remove Delay Version**
09/07/15,07:25:44+0[,90715,7254900,-26.619944,152.858963,0.30,406.30,0.00,93,10]
* Date is the wrong format
* There is a
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

Thread 21 (2015-07-21):

CMS errors?

Fyod, 2015-07-21:
Anyone else experiencing CMS errors, usually 604 and 10 on SMS?
Not sure if this is necessarily coding issue or network/module.
I have seen some incoming SMS printed in Serial Monitor a couple times.

m4rkw, 2015-07-21:
I get one on startup, I think it's due to not correctly verifying the previous command.  SMS works perfectly after startup though.  Are you using raw mode or http?  I think http is currently broken, if you're using raw mode do sms commands work?

Fyod, 2015-07-21:
Using http. I'll test raw. Thanks!

m4rkw, 2015-07-23:
Hi Fyod, http mode should be working now.  If you're still experiencing this issue please could you let me know if it just happens on the startup sms check, or whether it happens continuously, and in either case post the output of the serial console (ideally with all the logs from startup of the tracker) so I can look into it for you?

Thanks,
Mark

Fyod, 2015-07-23:
It looks like the buffer isn't cleared before sms check.

sms_check() started
th Suhosin-Patch
X-Powered-By: PHP/5.2.6-1+lenny9
AccAT+CMGL="REC UNREAD"

+CMS ERROR: 604
Deleting READ and SENT SMS
Modem Reply:
AT+QMGDA="DEL READ"

Modem Reply:
+CMS ERROR: 604

Modem Reply:
AT+QMGDA="DEL SENT"

Modem Reply:
+CMS ERROR: 604

sms_check() completed

Fyod, 2015-07-24:
Looks like that may have been my mistake, but now I get:

```
sms_check() started
AT+CMGL="REC UNREAD"

+CMS ERROR: 3

Call Ready
Deleting READ and SENT SMS
Modem Reply:
AT+QMGDA="DEL READ"

Modem Reply:
+CMS ERROR: 604

Modem Reply:
AT+QMGDA="DEL SENT"

Modem Reply:
+CMS ERROR: 604
```

Fyod, 2015-07-25:
Issue resolved.
I had updated my code with Tony's update (https://github.com/TonyArmitstead/opentracker/commit/864ddd0126350bc58ece3758565b72a246f8a0ba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)
and I missed two lines, surprisingly didn't get an error.

Btw: where can I submit code contribution? I made some code to send network name and battery status (percentage, voltage) in the data packet when running off a lipo.

Fyod, 2015-07-25:
So now that that works, I found that enabling GSM_STAY_ONLINE 1 causes the data to be sent once, then it fails because the modem returns ALREADY CONNECT
```
collect_all_data() completed
Current:
*** datat here is correct ***

gsm_send_at() started
gsm_send_at() completed
Modem Reply:
AT
AT

Modem Reply:
OK

gsm_disconnect() Disabled
GPRS deactivated.
gsm_connect() started
Connecting to remote server...
0
Modem Reply:

Modem Reply:
OK

Modem Reply:
AT+QIOPEN="TCP","foo.foo.com","80"

Modem Reply:
ALREADY CONNECT

Modem Reply:

Modem Reply:
ERROR

Can not connect to remote server:
foo.foo.com
Connecting to remote server...
1
Modem Reply:
AT+QIOPEN="TCP","foo.foo.com","80"

Modem Reply:
ALREADY CONNECT

Modem Reply:

Modem Reply:
ERROR

Can not connect to remote server:
146.255.26.38
gsm_connect() completed
Error, can not send data, no connection.
Can not send data
Sleeping for: 3647ms
```

ilevans, 2015-07-26:
Hi @Fyod

The updates.geolink.io site closes the connection so that another can be opened.

If the site you are using does not close the connection, then it would be necessary to issue a AT+QICLOSE instead of the AT+QIDEACT.

Extract from one of my test logs
--
gsm_send_at() completed
Modem Reply:
AT
AT

Modem Reply:
OK

gsm_disconnect() Disabled
GPRS deactivated.
gsm_connect() started
Connecting to remote server...
0
Modem Reply:

Modem Reply:
OK

Modem Reply:
AT+QIOPEN="TCP","updates.geolink.io","80"

Modem Reply:
OK

Modem Reply:

Modem Reply:
CONNECT OK

Connected to remote server:
updates.geolink.io
gsm_connect() completed
gsm_send_http(): sending data.
15/07/26,00:29:09+0[260715,292000,-26.619543,152.859207,0.80,448.00,0.00,142,5]

gsm_send_http(): Length of data packet:
118
gsm_send_http(): Length of header packet:
171
Modem Reply:
AT+QISEND=171

Modem Reply:
>
gsm_validate_tcp() started.
Modem Reply:

Modem Reply:
SEND OK

gsm_validate_tcp() data delivered.
gsm_validate_tcp() completed.
gsm_send_http(): Sending IMEI and Key
Modem Reply:
AT+QISEND=38

Modem Reply:
>
Modem Reply:

Modem Reply:
SEND OK

gsm_send_http(): Sending body
gsm_send_http(): Body packet size:
80
gsm_send_http(): Sending data chunk:
0
gsm_send_http(): chunk length:
80
gsm_send_http(): data sent.
parse_receive_reply() started
Modem Reply:
AT+QISEND=80

>
Modem Reply:

SEND OK

Modem Reply:
AT+QIRD=0,1,0,100

OK

+QIRDI: 0,1,0

Modem Reply:
AT+QIRD=0,1,0,100

+QIRD: 78.46.45.61:80,TCP,100
HTTP/1.1 200 OK
Server: nginx/1.8.0
Date: Sun, 26 Jul 2015 00:29:24 GMT
C
Modem Reply:
AT+QIRD=0,1,0,100

+QIRD: 78.46.45.61:80,TCP,49
Connection: close

#t:15/07/26,00:29:24+00
#eof
OK

0, CLOSED

0, CLOS
Found header packet
Modem Reply:
AT+QIRD=0,1,0,100

ERROR

No more data available.
Data was fully received by the server.

--

Fyod, 2015-07-26:
Wonderful, going to try that today! Thank you!

Fyod, 2015-07-28:
Same problem with QICLOSE.
It looks as if the code doesn't accept the Already connected reply.

ilevans, 2015-07-28:
I have put links to the GSM and GPS manuals on the wiki.
It sounds like the close is not working.
Alternatively you could look at changing the cost to recognise the Already connected reply as well.

opensourcegps, 2015-07-29:
```
#define GSM_STAY_ONLINE 1
```
breaks sms checks with:
+CMS ERROR: 604

Set to 0 by default at the moment and need further investigating, possibly modem can not return SMS when connected to remove server.

m4rkw, 2015-08-03:
@opensourcegps I think 604 is "cannot allocate control socket" so i think your guess is probably right.  I guess users who want to use that option could implement sms handling server-side and then feed the commands back to the tracker in the http response.  Infact, thinking about it, I think that might already just work if #<command> is returned by the server rather than #eof (or maybe preceding it).

Fyod, 2015-08-03:
I agree, SMS is working OK when there's a disconnect or if the device is restarted.
# should be returned by the server as the first character in the header?

ppescher, 2016-07-01:
Recent code issues AT+QICLOSE instead of AT+QIDEACT when GSM_STAY_ONLINE=1, so the GPRS session is maintained but TCP connection is closed anyway.
However, the server does close the TCP connection before the client does, so that error might be related to something else.
I never saw it happen.

Closed 2016-07-01.

Thread 32 (2015-08-12):

Code formatting reorganization

opensourcegps, 2015-08-12:
I would like to propose formatting current code style into single and consistent format. This affects indents, parenthesis style, etc. Current code was based on some non-standard style and it might be a good idea to switch it now to more common and comfortable version.

Once we choose most standard format, we stick with it for further development. Please propose format that will work for you, or just submit pull request with formatted files and we will accept it.

It's important to choose such format that will be comfortable for the community and further development.

m4rkw, 2015-08-12:
2 character space indent is very popular I think.  I tend to prefer tabs but spaces seems more common, and also causes less issues if you have strings in the code that contain spaces.

opensourcegps, 2015-08-12:
agree with 2 character space indent

m4rkw, 2015-08-12:
Would also be nice to set standards for things like where the opening { is, on the same line or the next line.  Eg:

if (FOO) {

vs

if (FOO)
{

I think the latter tends towards more readability but it's really a personal choice thing.

opensourcegps, 2015-08-12:
if (FOO) { - I think this is more common. Even through I got used to second option. Maybe we can just use some IDE to auto format everything and make it standard?

m4rkw, 2015-08-12:
Most IDEs will have settings for how the indentation should work which people play around with, and programmers tend to be fussy about the tools they use (I for example mostly only edit code in vim).  I think if the community is going to be big it will inevitably encounter users who want to use their choice of editor, which should be fine as long as it's configured to the coding standards.

I'm happy with either if (FOO) {  or the other style, imho it's more important that it's consistent than which way we do it.

m4rkw, 2015-08-12:
Have reformatted the code with the following style guides:

- 2-character space indentation
- { is always on the same line as the block initiator rather than a new line
- no spaces between function names and opening (
- no trailing whitespace

Happy to change any aspect of this, as now that it's all consistent changes to the style guidelines should be pretty easy.

Once happy with it it's probably worth putting these into the README as a guide to potential contributors.

dimetron, 2015-08-12:
To make it simple to all who is new to the project, Arduino build in Auto-format Ctrl-T should be sufficient.
However, it doesn't solve  FOO{} issue.

What about Google style guide ?
https://google-styleguide.googlecode.com/svn/trunk/cppguide.html

Or the one from Linux kernel ?
https://www.kernel.org/doc/Documentation/CodingStyle

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

dimetron, 2015-08-12:
Mark - do you agree on AutoFormat? Could you please apply/commit that also on top ?
This will prevent future formatting issue, of course, if everyone will do auto format before commit ;)

m4rkw, 2015-08-12:
To be honest I think the Arduino IDE is a pos and any use of it should be discouraged, but you're not wrong that it's probably what most people will end up using.  I don't have it to hand at the moment, but if running autoformat doesn't totally bork everything / make it unreadable then I'm not against doing it.  I would like to note however that I'm pretty sure a long of the indentation issues and trailing whitespace that were in the codebase are the result of people use that IDE.

dimetron, 2015-08-12:
I am not a big expert in cpp, but if you are saying ArduinoIDE is a pos, lets find alternative.

Then maybe some other tool like Astyle can help ?  It works under Win/Linux/OSX
http://sourceforge.net/projects/astyle/?source=typ_redirect

Here is example after default format applied opentracker:
https://github.com/geolink/opentracker/compare/master...dimetron:master?diff=split&name=master

I guess one additional command to git would not make a big difference ?

dimetron, 2015-08-12:
Same topic on SOF - http://stackoverflow.com/questions/841075/best-c-code-formatter-beautifier

m4rkw, 2015-08-12:
Well, if you're talking about choosing a new IDE that everybody who works on opentracker should use, that's not going to work for reasons already stated (people like to use the tools they like).  If you're just talking about running it through a prettifier, I'm not sure it's necessary at this point - I already cleaned it up by hand to the point where changes to the formatting resulting from conscious decisions to do things a different way can probably be made with simple regex replaces.

opensourcegps, 2015-08-12:
I agree that we can't force people to use specific IDE or some prettifier. Let's just keep it simple, it's formatted now and we can put notice in Wiki what format we use and ask to use it too. Basically case closed.

The main reason for this is just that pull request does not have whole file modified, because somebody put 3 spaces instead of 2 on every line. Apart from that, everyone can use what ever tools they like. At the end it's not a big deal, if somebody puts some extra spaces on their own lines they commit, this is still not a problem. As long as the code works :)

Closed 2015-08-14.

Thread 33 (2015-08-13):

Flash storage

Fyod, 2015-08-13:
This isn't really an issue, but a question - is there a good alternative to the DueFlashStorage for other board alternatives?
Also, just an idea, it would be great if future versions could implement the TinyGPS++ library, which has some really cool features.
Cheers!

Closed 2016-07-01.

Thread 34 (2015-08-13):

Detecting the engine running

m4rkw, 2015-08-13:
So the current ignition detection actually just detects that the key is at position 2, rather than the engine is actually running (because that's all we get from the ignition wire).  It's just occurred to me that you can easily see whether the engine is running by the battery level - if the ignition signal goes positive and the voltage dips then it's just the key at position 2.  If the signal goes live and the voltage increases then the engine is running.

Should be pretty easy to reliably code this into the software, I'll do it when I have time but am documenting this here for now.

fhasex20, 2015-08-13:
Battery voltage should be about 13,3-14,8 if engine is running, at 24volt Systems it May be 26-28volts. But the easiest thing would be to hook up can-bus and watch rpm's, in this case you could get almost any data from the bus. Last time i tried canbus wasn't working correctly, back in the Tigal daysSo far,Ferdinand                                                                                                                                                                                                                Von: Mark WadhamGesendet: Donnerstag, 13. August 2015 11:28An: geolink/opentrackerAntwort an: geolink/opentrackerBetreff: [opentracker] Detecting the engine running (#34)So the current ignition detection actually just detects that the key is at position 2, rather than the engine is actually running (because that's all we get from the ignition wire).  It's just occurred to me that you can easily see whether the engine is running by the battery level - if the ignition signal goes positive and the voltage dips then it's just the key at position 2.  If the signal goes live and the voltage increases then the engine is running.

Should be pretty easy to reliably code this into the software, I'll do it when I have time but am documenting this here for now.

—Reply to this email directly or view it on GitHub.

m4rkw, 2015-08-13:
Yeah CAN-bus is on my todo list.. for some mythical future where I don't have a dayjob and am not about to have a kid :D  I'll get it to eventually

fhasex20, 2015-08-13:
Iam on it, will let you know if i success                                                                                                                                                                                                                                                                                                                                         Gesendet von meinem BlackBerry 10-Smartphone.                                                                                                                                                                                                                Von: Mark WadhamGesendet: Donnerstag, 13. August 2015 15:26An: geolink/opentrackerAntwort an: geolink/opentrackerCc: fhasex20Betreff: Re: [opentracker] Detecting the engine running (#34)Yeah CAN-bus is on my todo list.. for some mythical future where I don't have a dayjob and am not about to have a kid :D  I'll get it to eventually

—Reply to this email directly or view it on GitHub.

Closed 2016-07-01.

Thread 35 (2015-08-23):

Programming on Linux and Mac

varlux, 2015-08-23:
I'm trying to install OpenTracker board in Arduino IDE (Linux 32bit) but, when i press "install" button i read a red message "Tool bossac is not available for your operating system" and procedure stops. Can somebody help me? Thanks

fhasex20, 2015-08-23:
You have to build bossac from source.Git Clone                                                                                                                                      https://github.com/geolink/opentracker-bossa.gitGit clone ‎ https://github.com/geolink/opentracker-arduino-board.gitEdit ‎local package_opentracker_index.jsonAnd remove bossac entry . Dirty, bu:t should work                                                                                                                                                                                                   Ferdinand Haselbacher                                                                                                                                                                                                                Von: varluxGesendet: Sonntag, 23. August 2015 19:13An: geolink/opentrackerAntwort an: geolink/opentrackerBetreff: [opentracker] Programming on LInux (#35)I'm trying to install OpenTracker board in Arduino IDE (Linux 32bit) but, when i press "install" button i read a red message "Tool bossac is not available for your operating system" and procedure stops. Can somebody help me? Thanks

—Reply to this email directly or view it on GitHub.

salanki, 2015-09-11:
The same works for Mac. I however had to modify the opentracker-bossa Makefile:

COMMON_CXXFLAGS=-arch i386 -arch x86_64 -mmacosx-version-min=10.10 -stdlib=libc++ -std=c++11
COMMON_LDFLAGS=-arch i386 -arch x86_64 -mmacosx-version-min=10.10

and also install wxmac:
brew install wxmac

ppescher, 2015-09-13:
FYI, the board suport package now includes linux binaries (since v1.0.1)
See https://github.com/geolink/opentracker-arduino-board/commit/98105ba1d54bdc6c8949accd23c333a4d9dc58de

To build the command line tool, you don't actually need wxWidgets. Just "make bin/bossac"

ppescher, 2015-09-16:
Can anybody please test the Mac OSX binaries, before the official release?

You should be able to get v1.0.2 of the board support package using this URL in your preferences: https://github.com/geolink/opentracker-arduino-board/raw/1.0.2/package_opentracker_index.json

That includes the OSX binary of the BOSSA tool.

varlux, 2015-09-17:
Grazie Paolo, seguiro' il tuo consiglio e ti faro' sapere

varlux, 2015-09-28:
OK, it works on Linux, Thanks!

ppescher, 2015-09-29:
Thank you varlux.
Any Mac user that can test on that platform?

Closed 2016-07-01.

Thread 36 (2015-08-29):

Reset GPS

varlux, 2015-08-29:
I tried to reset GPS with this code

DigitalWrite(resetpin, HIGH);
delay(50);
DigitalWrite(resetpin, LOW);

but GPS do not reset AND i lose data from Serial1.......

Can you help me?

ppescher, 2015-09-13:
pinMode(PIN_RESET_GPS, OUTPUT);
  digitalWrite(PIN_RESET_GPS, HIGH);
  delay(50);
  digitalWrite(PIN_RESET_GPS, LOW);

Have you tried this sequence?
When the module is reset, data flow on the serial port is stopped and resumed after reset is complete.

varlux, 2015-12-13:
OK.... it works.

Thanks

Closed 2015-12-14.

Thread 37 (2015-09-09):

Can't SPI

firstroboman, 2015-09-09:
I need to communicate with a SPI based sensor and tried including SPI.h in Opentracker_3_0_1 but now it won't build.

//External libraries
#include < SPI.h >
#include < TinyGPS.h >
#include < avr/dtostrf.h >
#include < DueFlashStorage.h >

Arduino IDE version is 1.6.5 and the board target is "Geolink OpenTracker"

Error messages are:
error: 'PIOC' was not declared in this scope
error: 'PIOD' was not declared in this scope

firstroboman, 2015-09-09:
Sorry .... some of the text was omitted from my initial post.  I'm trying to include SPI.h under the External libraries comment.

ppescher, 2015-09-09:
Just pushed a new commit/branch at https://github.com/geolink/opentracker-arduino-board/commit/393eb67861007427d8f100a8b9b99685363511e8 with a proposed fix.

You can get the relevant file from: https://github.com/geolink/opentracker-arduino-board/raw/1.0.2/1.0.2/libraries/SPI/SPI.cpp

And replace it on your folder:
%AppData%\Arduino15\packages\opentracker\hardware\sam\1.0.0\libraries\SPI
Or:
%AppData%\Arduino15\packages\opentracker\hardware\sam\1.0.1\libraries\SPI

Depending on what version you are using. The only difference between 1.0.0 and 1.0.1 is Linux binaries for BOSSAC (handling sketch upload).

If you confirm it works, I will make a new release of the board support package.

Closed 2016-07-01.

Thread 39 (2015-09-15):

Can't read I2C

adrfrank, 2015-09-15:
I need to integrate some i2c sensors to the opentracker device, when I try to request data from the these sensors nobody is responding.

I verified all connections for the i2c bus, including pull ups resistors, and all seems to be fine. I though it was a sensor problem, but this problem was present in  all sensors that I connected and only with the OpenTracker, because I tested these sensors with UNO and DUE and nothing was wrong.

I think the problem is in the variant for Due-OpenTracker but it is only a suspicion.

ppescher, 2015-09-17:
We verified I2C works as intended with an external EEPROM device. There are no known software or hardware problems.
Please check your connections and post the relevant code if you still have problems, along with details on your setup.

adrfrank, 2015-09-17:
I'm using the pins 3 and 4 from the j2 connector. The sensor is a MCP9808 and I tried to read using the arduino due library for this sensor.

What did you use to read the I2C bus? (I used wire.h)  Can you please post the setup for your i2c test?

ppescher, 2015-09-18:
```C++
#include <Wire.h>

#define Console SerialUSB
#define EEPROM_ADDR  0x50 // 24LC128 EEPROM I2C Device Address

void setup()
{
  delay(3000);

  Wire.begin();
  uint8_t data = 0x69; // Test data
  uint16_t addr = 0x1234; // Test address

  Wire.beginTransmission(EEPROM_ADDR); // Chosen base address
  Wire.write(addr >> 8);  // send MSB of the address
  Wire.write(addr & 0xFF); // send LSB of the address
  Wire.write(data); // send data
  Wire.endTransmission();

  delay(100);

  Wire.beginTransmission(EEPROM_ADDR); // Chosen base address
  Wire.write(addr >> 8);  // send MSB of the address
  Wire.write(addr & 0xFF); // send LSB of the address
  Wire.endTransmission(false); // don't generate a stop
  Wire.requestFrom(EEPROM_ADDR, 1, true); // Start read and stop at the end
  if (Wire.available() == 1) { // if one bytes was received
    Console.println(Wire.read());   // print the reading
  }
}
```
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

Please check your connections, make sure the sensor is powered at 3.3V and that you use the device 7-bit I2C address for communication with the Wire library.

adrfrank, 2015-10-12:
Thank you, the problem was present when I connect more than two I2C devices. And I resolved it to change the connector type.

Closed 2015-10-12.

Thread 42 (2015-12-14):

gsm_get_reply()

agraciabona, 2015-12-14:
Hi,
I began to use opentracker with software release V2.0.1 and Arduino IDE 1.5.8. I modified that software to make my own and it works fine.

Now I tried to use my opentracker software with new IDE 1.6.x but I had problems in function gsm_get_reply(). The problem was that characters were lost when reading from gsm modem in parse_receive_reply(). I see that IDE 1.6.x comes with “#define SERIAL_BUFFER_SIZE 128” in RingBuffer.h and this is the problem. In V2.0.1 documentation in “Opentracker2_Manual_1.0.1.pdf” it says to write “#define SERIAL_BUFFER_SIZE 256”. My software only works fine with 256...

I think it is necessary to include in current documentation instructions to modify this file or supply a RingBuffer.h file with 256 not 128.

ppescher, 2015-12-14:
You don't need to patch your Arduino IDE manually anymore.
Please try to install the board support package from https://github.com/geolink/opentracker-arduino-board
It may be compatible with v2.0.1 of the software, or you can try v3.x from this repo.

agraciabona, 2015-12-31:
Ok I see now the support package https://github.com/geolink/opentracker-arduino-board comes with 256 in RingBuffer.h. Anyway, if there is a lot of data allways some characters are lost. Now I'm working with 2048 in SERIAL_BUFFER_SIZE in RingBuffer.h to avoid problems. I think the problem is in RingBuffer but I'm not sure. I'll try to find it out.

Closed 2016-07-01.

Thread 44 (2016-01-21):

Documentation of pinouts is unclear

leekillough, 2016-01-21:
1. I am confused on Page 21 of the manual, where it implies there are extra "Analog, PWM, GPIO" pins on the expansion header. Are they the ones labeled EXT_PA21, EXT_PA22, EXT_PA23? Can they each be programmed as either Analog IN, Digital IN, Digital OUT, Open Collector, or PWM, or are they limited to digital in/out?

2. What Is EXT_NS0? Is it a digital output which can be used to select a SPI slave device, as well as a possibly independent digital output if you don't need to select between multiple SPI devices?

3. How many, if any, of the CAN, I2C, SPI, and serial (RX/TX + RX2/TX2) pins can be reprogrammed for other functions, and to what degree (analog, digital IN/OUT/OC, PWM)?

4. Is EXT_SCK the SPI sclock, and is EXT_SCL the I2C sclock? I wanted to make sure, since I2C and SPI were not mentioned in detail in the manual. Perhaps sections on I2C and SPI, with simple circuit examples, should be added.

ppescher, 2016-01-21:
The design of OpenTracker 2 is derived from Arduino Due and tries to be as much software compatible as possible. Some pins are configured the same way, some are different.
Please have a look at: https://github.com/geolink/opentracker-arduino-board/blob/master/1.0.2/variants/geolink_opentracker/variant.h and CPP file, where you can see what function is the default one for each pin.

To answer your questions:

1. Usually all the pins can function as digital I/O, some have PWM capability, some can be analog inputs. See OpenTracker "variant.h/.cpp"

2. NS0 is standard naming for Atmel SAM3 MCU. It is a "slave select" or "chip select" pin for the SPI.

3. Again, please look at "variant.h/.cpp" and refer to the SAM3AC4 datasheet for multiplexed pin functions. The only analog pins in the expansion header are PA22/PA23 (you can use AIN_pin_name definitions for analog functions) and PA21 can be a PWM output.

4. SCK is the SPI serial clock. SCL is the I2C serial clock. This is common naming, but thanks for your comments. We'll try to improve the manual.

Closed 2016-07-01.

Thread 45 (2016-01-29):

GPS module reset 10-30s cycles

speeedy81, 2016-01-29:
I was wondering why my opentracker was loosing fix while driving and even stationary. When investigating more I noticed that GPS module reset without any reason.  Could it be because of the power source (voltage not stable) because with some power sources it does not happen ?

m4rkw, 2016-01-29:
When you say the GPS module resets, what do you mean exactly?  Are you seeing it lose the fix in the serial output and go through all the blurb again looking for a new fix?

agraciabona, 2016-01-29:
My opentracker resets sometimes (not allways) when turning on the engine. Only in this case. Driving, it doesnt happens. I think if voltage drops under a certain value it resets.

speeedy81, 2016-01-30:
Yes, I see gps losing the fix from serial data.

Here is caption of that data when that happens, tracker was powered at my desk from 12V battery so power source was very stable.

$GPVTG,90.42,T,,M,0.24,N,0.44,K,A*04
$GPGGA,114525.000,6130.5781,N,02336.0557,E,1,6,1.39,104.8,M,20.5,M,,*51
$GNGSA,A,3,09,23,07,02,16,,,,,,,,1.68,1.39,0.94*1F
$GNGSA,A,3,67,,,,,,,,,,,,1.68,1.39,0.94*14
$GPGSV,3,1,11,09,78,138,34,23,44,099,35,07,44,192,14,02,33,275,22*7D
$GPGSV,3,2,11,16,32,067,35,06,22,227,19,26,22,037,28,05,21,304,29*70
$GPGSV,3,3,11,30,15,206,14,29,14,343,23,40,12,135,*44
$GLGSV,1,1,01,67,33,126,32*51
$GNGLL,6130.5781,N,02336.0557,E,114525.000,A,A*4D
$GNRMC,114526.000,A,6130.5790,N,02336.0550,E,0.3$PMTK011,MTKGPS*08
$PMTK010,001*2E
$PMTK011,MTKGPS*08
$PMTK010,002*2D
$GPRMC,235943.799,V,,,,,0.00,0.00,050180,,,N*4C
$GPVTG,0.00,T,,M,0.00,N,0.00,K,N*32
$GPGGA,235943.799,,,,,0,0,,,M,,M,,*45
$GPGSA,A,1,,,,,,,,,,,,,,,*1E
$GPGSV,1,1,00*79
$GLGSV,1,1,00*65
$GPGLL,,,,,235943.799,V,N*77
$GPRMC,235944.799,V,,,,,0.00,0.00,050180,,,N*4B

Closed 2016-07-01.

Thread 46 (2016-02-01):

Tracker hangs

agraciabona, 2016-02-01:
My opentracker is working 24h a day, it is allways powered on. About every 3 days it hangs. Sometimes it hangs twice in a day and other times it is 5 days working without problems. When it hangs I realise of it because It stops trasmiting data and if I connect the serial cable to it, my computer says "usb device not recognized". Power off and on and tracker works again. It looks like an electrical problem, not a software problem. I installed two diodes (one in 'power' and the other one in 'ignition') to avoid voltage peaks but it still happens. Has someone experienced something similar?

ZdenekAster, 2016-02-01:
I have 5 opentrackers in truck. All opentrackers have the same software. Three of them is work without problems. But two have the same problems like yours....

agraciabona, 2016-02-04:
ZdenekAster, your opentrackers are allways in the same trucks? Or have you made the test of changing one that fails and put it in other truck?

ZdenekAster, 2016-03-04:
No, I have 5 truck. In every truck one opentracker. In generally Opentracker hangs at the same place. Near border France/Spain, near city Lyon and etc. I test restart GSM module before every communication. So far, it looks good, but I test only one week.

m4rkw, 2016-03-04:
@ZdenekAster Next time you go that way I'd suggest having a computer connected to the serial output and see what point it hangs at.  Check this a few times and if it's always in the same point in the run loop it may help with debugging it.

m4rkw, 2016-03-04:
@ZdenekAster If you can run this test 2-3 times and send me the serial buffers for each test up to the point where it hangs (don't need the entire thing, just one or two complete loops before the hang) I'll look into it for you.

ZdenekAster, 2016-03-04:
That is difficulty. On my opentracker on my desk work correct whole month. This problem is in the truck on the road, it is not possible travell with truck and notebook and grab serial output for debug.

m4rkw, 2016-03-04:
@ZdenekAster appreciate it's difficult but if it is a software glitch that's the only way we'd be able to debug it, otherwise there's nothing to go on.  The fact that it seems to be happening in the same location for you every time suggests there may be some set of circumstances happening that the tracker somehow can't deal with.  Without seeing where it gets stuck we have no clues at all for debugging.  Maybe if you have a spare tracker you could connect it to the 12V socket so it could just sit on the passenger seat with a laptop and the aerial on the dash?  Just an idea, hope you get it sorted anyway!  Mark

agraciabona, 2016-03-04:
I've been working on this issue. I think there are two kind of hangs:

A.- It seems a hardware problem: when you connect usb cable the computer shows 'usb device not recognized'. I have no idea of what to do in this case.

B.- It seems a software problem: sometimes, when it tries to connect it allways gets IP_INITIAL, allways! forever! even disconnecting and connecting again. This happens with my car parked in my house: I see tracker working during hours and suddenly it stops trasmiting. The only way to get out of it is doing a reset. I've programed a reset after several connect failures and I It solves the problem.

Problem 'B' happens many more times than 'A', in fact I've seen 'A' only two times. So, I think ZdenekAster  is having problem 'B' because he says he solves it doing a gsm restart.

m4rkw, 2016-03-06:
Interesting.  I've had A once but it only froze when I plugged the usb cable into a mac, so I assumed there was some kind of driver glitch.  I wired a push-to-break reset switch in so I could reset it if it happens again.  Haven't seen B though, my tracker has been working for a long time without freezing up.

I'm guessing you're using the latest code from the master branch, so something about your situation must be different from mine and the others who don't see the problem.  Could be network related maybe, have you tried using a different network to see if that makes a difference?  A quick google suggests that "IP INITIAL" isn't an error message, rather it indicates a state where the IP stack is initialised.  Could you post the AT commands being sent before and after it gets stuck at this point, ideally the full serial output?  One of the AT commands must be triggering a hang and it'd be interesting to see which one.  Mark

agraciabona, 2016-03-07:
I'm not using last code from master branch, I modified myself but the communication procedure is the same. I know IP_INITIAL is not an error but how is it possible it gets stuck on it? disconnecting and connecting forever and allways getting IP_INITIAL? And, if opentracker issue a reset it starts comunication inmediatly... This happens without moving the tracker, so gsm coverage doesn't change. I don't have the serial output when the problem begins, but I suppose that after a correct communication the next one comes with the problem. Anyway, this is not a big problem for me, now I can get rid of it issuing a reset and I only lose communication during 2 or 3 minutes.
To me the other hang ('A' type) is worse because it is impossible to program anything to avoid it, the tracker seems electrically 'dead'. Maybe it only happens when the tracker is onboard a vehicle powered by the vehicle battery because voltage is unstable. Anyway, I found a way to get rid of it: I put a diode in the power supply cable to limit voltage to 12V. Doing this, when the car driver starts the engine, power supply falls so much so the tracker resets because low voltage :-) and if it was hanged it comes to life again.
So, now I can avoid all kind of hangs, or I hope so... I'll keep you informed.
One question for @ZdenekAster: what happens when your tracker hangs? You loose communication with your truck until it comes next to you and you reset it?

ZdenekAster, 2016-03-07:
2 agraciabona: When tracker hangs, loose communication. if someone connect/dissconnect main connector (power off/on ) tracker normaly work. I think that problem to registration to GSM network in roaming. It is difficult to repeat this problem because, that problem occurs twice a month at home on desk track work month without problem.
I design pcb with atxmega and sd-card for expansion connector on tracker for log debug communication, but currently i do not have time for develop this :-(

agraciabona, 2016-03-07:
If it is a problem in registration to GSM network in roaming, it should work again when returning to home country? My taxi whent once to France (I live in Barcelona) and it lose comunication in France, but when returning to Spaint it worked again.

ZdenekAster, 2016-03-07:
No, only power reset solve this problem. Truck ride from Czech (home country), Germany, France, Spain and back.. Track hangs very often near France/Lyon and Spain/La Jonquera...

ZdenekAster, 2016-03-11:
Today, I get report from my prototype logger with problem hangs. Modem reply ERROR on command AT+QIOPEN....
[logfile.txt](https://github.com/geolink/opentracker/files/169918/logfile.txt)

agraciabona, 2016-05-13:
I haven't seen again hang type 'A'. I put in my car a bigger battery, maybe this is the reason...
Type 'B' stills happens but I modified software to issue a reset if communication is lost during 3 minutes and this is the way to make it work again.

ppescher, 2016-09-14:
The hardware issue might be related to the presence of a resettable fuse on-board, in series with the power supply. With higher current consumptions or higher temperatures it may lead to an excessive voltage drop (due to increased resistance), and even cause device resets with low input voltages (or improper power cycling that cause device lock-out).
The resettable fuse has been removed since board revision 2.4. An external in-line fuse should be used instead.

Closed 2017-04-05.

Thread 47 (2016-03-05):

MQTT Support

kurky91, 2016-03-05:
We tried to use the paho MQTT client library for arduino but the GSM module is not the same and some other dependencies make life hard..

Do you have any plans to implement the MQTT protocol on the opentracker?

If yes: Do you know roughly when we can use it?
If no: Do you have any advice on how we can achieve MQTT communication by ourselves?

Thank you very much

m4rkw, 2016-03-06:
Hi @kurky91 just curious what it is you want to achieve by using MQTT with the opentracker?  The run loop in the codebase for opentracker is fairly long, around 16 seconds or so I think, so you'd likely see fairly high latency trying to use this.

kurky91, 2016-03-07:
Hello @m4rkw
MQTT is a good bet to connect little devices because of the very small overhead and quality of service features. But the real reason is that we want to connect to a plattform that only supports MQTT at the moment.

We don't go for speed. Maybe there is no real need for MQTT since we have enough power in the car.

But I guess this question is still eligible: Why using HTTP when there is MQTT?

m4rkw, 2016-03-08:
Hi @kurky91, I didn't write the original software so I can't say why it was originally designed to use HTTP rather than MQTT but if I had to guess I'd say because HTTP is simpler and more common.  The way trackers traditionally work is simply by reporting their position (and other data) at an interval and pushing it via HTTP is more than sufficient for this.  Also given the availability of a GSM connection which can be used to parse sms commands, having the commands sent via MQTT would seem to introduce unnecessary complexity (most people have a phone, not everyone has something that can talk MQTT and even if they did sms often works in areas where data coverage does not).

I don't think I really understand your use case with regards to MQTT, but if the aim is just to have the opentracker spitting out MQTT messages then you could solve this by putting a translation layer on the MQTT server that receives the HTTP (or raw) data from the tracker and translates it into MQTT messages.

Daniel-dk, 2016-06-13:
MQTT would make it a bit simpler to parse tracker information when rolling your own tracking server or getting data into other systems ( setting up a MQTT server is easier for some than creating a REST service ) - like NodeRED or Mosquitto

Implementation of MQTT ( and using existing libraries ) would need some rework of teh underlying GSM interface in opentracker to use Arduino's Stream interface like Ethernet and Wifi libs do ( essentially a rewrite of the GSM interface of openTracker ).

one could use the Arduino GSM as a starting point - M10 and M95 have identical commands regarding the TCP/IP stack, the big issue there is the hard coded "software serial" for AVR in the Arduino library - it is the reason for incompatibility with the Arduino DUE and Zero.

- https://github.com/arduino/Arduino/tree/master/libraries/GSM

or one could use the SIM900 /800  based libraries- they are simpler to follow than the Arduino GSM lib, but the modems are not that similar so a lot of datasheet surfing is needed and one can only use them as a "wireframe" and rewrite the modem AT commands and the state machine to fit the M95
 - https://github.com/r-map/rmap/tree/master/arduino/sketchbook/libraries/sim800

whichever way one goes, its a big chunk of work...

Daniel-dk, 2016-09-13:
it looks like the Arduino.org group have edited their GSM library to work on the Zero ( samd arch )
they are still using SoftwareSerial  and seemt o have changed the pin handling methods to work with the Arduino Zero
so  Due / OpenTracker port should be simpler with that as a starting point but still not the ideal case using a real UART/USART and some datasheet surfing would still be required.

Thread 48 (2016-03-07):

Pin mapping not clear

dgiardini, 2016-03-07:
Not sure how to match I/O numbering with labels on circuits or schematics. Seems there is not macros defined for EXT_TX, EXT_RX,IO_TO_EXT and so.

ppescher, 2016-03-08:
Please see: https://github.com/geolink/opentracker-arduino-board/blob/master/1.0.2/variants/geolink_opentracker/variant.h

There you can find PIN_EXT_RX and PIN_EXT_RX.

IO_TO_EXT is a signal that goes from the MAIN connector to the Expansion interface directly. It is not connected to the MCU, so there is no pin mapping defined. It is reserved for use by expansion cards.

Closed 2016-03-08.

Thread 50 (2016-05-08):

I don't see into Manage Library the "OpenTracker Boards"

oscaroxy, 2016-05-08:
I've put into preferences in label "Additional Boards Manager URLs" the json: "https://cdn.rawgit.com/geolink/opentracker-arduino-board/master/package_opentracker_index.json"

but I don't see into Manage Library the "OpenTracker Boards", Why?
Where Do I mistake?
thanks

oscaroxy, 2016-05-08:
I resolve, I don't go to Mange Library but in tool -> board
thanks

Closed 2016-05-08.

Thread 51 (2016-05-08):

arduino 1.6.8 and avr/dtostrf.h

oscaroxy, 2016-05-08:
I've setted Arduino Uno but when I compile receive the error:
```
/Users/oscar/Desktop/opentracker-master/Opentracker_3_0_1/Opentracker_3_0_1.ino:7:25: fatal error: avr/dtostrf.h: No such file or directory
 #include <avr/dtostrf.h>

```
I'm newbiein arduino, so How do I resolve it?
thanks

oscaroxy, 2016-05-08:
I resolve, I installed "OpenTracker Boards" and all i's ok.
thanks

fhasex20, 2016-05-08:
Some things in live, just resolve
Am 08.05.2016 10:29 schrieb "oscaroxy" <notifications@github.com>:

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

Closed 2016-05-08.

Thread 52 (2016-05-08):

Mac Yosemite I don't see usb port

oscaroxy, 2016-05-08:
I have opentracker,  it work fine, the leds (red and green) blink... but when I connect the usb with arduino IDE I don't see usb port but only bluetooth... I've Mac Yosemite.

I tried to install "FTDI chip" like:
`http://www.mommosoft.com/blog/2014/10/24/ftdi-chip-and-os-x-10-10/`

but also if I run
`sudo kextload /System/Library/Extensions/FTDIUSBSerialDriver.kext/`

I don't receive nothing result with command
`ls /dev |grep usbserial`

I should see

`cu.usbserial-A9GBBDLL`
`tty.usbserial-A9GBBDLL`

without this I don't see port in arduino IDE, so I can't program the opentracker... :-(

Can anybody help me?
thanks

ppescher, 2016-05-08:
Hello,
There is no FTDI chip in OpenTracker. It works the same way as for Arduino DUE.

For Windows you need to install drivers that are provided with Arduino IDE installation.
For Linux/MacOSX I'm not sure, but I think you don't need any additional driver. You should see the serial port listed in the Arduino IDE menu. It may be "usbmodem" instead of "usbserial".

That of course only if the board is running correctly.

oscaroxy, 2016-05-10:
I am going crazy, I tried everything but nothing, my PC don't see the board ... I tried also by windows 8.1, don't only by Mac OSX...
In attach I put I see... the leds blink so power there is... the usb is connected... the board is installed into Arduino IDE, look bottom in image for to see opentracker board (in preference I put the json)...
the only thing I didn't do is the SIM, but I don't believe that I need SIM because the PC don't see

[opentracker_img.zip](https://github.com/geolink/opentracker/files/257291/opentracker_img.zip)

ppescher, 2016-05-10:
Please do your tests on Windows before you move to MacOSX.
When the USB cable is plugged in at both ends, you should see the board as a new serial port, as in the following screenshot:
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

The board can work without USB cable, it is not powered by USB.
If you don't see the virtual serial port, please first check the USB cable. Try to use the same cable with something else, for example to copy any file from your smartphone to your PC. Or try to use another USB cable with the OpenTracker, sometimes the connector gets loose and makes poor or no electrical contact.

oscaroxy, 2016-05-10:
You are my hero and I'm stupid ... It was the usb cable, now it work fine both Windows and Mac... I'm sorry and thanks a lot in order to patience.
Your product is wonderful :-) I'm happy in order to have buy it

Thanks

Inviato da iPhone 6

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

Closed 2016-05-11.

Thread 53 (2016-05-15):

Method name - openPort(); Exception type - Port busy

oscaroxy, 2016-05-15:
I don't understand why when I uplaod 2 sketch the second obtain this error:
`processing.app.debug.RunnerException
	at cc.arduino.packages.uploaders.SerialUploader.uploadUsingPreferences(SerialUploader.java:141)
	at cc.arduino.UploaderUtils.upload(UploaderUtils.java:78)
	at processing.app.Sketch.upload(Sketch.java:1186)
	at processing.app.Sketch.exportApplet(Sketch.java:1160)
	at processing.app.Sketch.exportApplet(Sketch.java:1132)
	at processing.app.Editor$DefaultExportHandler.run(Editor.java:2381)
	at java.lang.Thread.run(Thread.java:745)
Caused by: processing.app.SerialException: Errore durante l'esecuzione del comando touch sulla porta seriale '/dev/cu.usbmodem1411'
	at processing.app.Serial.touchForCDCReset(Serial.java:87)
	at cc.arduino.packages.uploaders.SerialUploader.uploadUsingPreferences(SerialUploader.java:130)
	... 6 more
Caused by: jssc.SerialPortException: Port name - /dev/cu.usbmodem1411; Method name - openPort(); Exception type - Port busy.
	at jssc.SerialPort.openPort(SerialPort.java:164)
	at processing.app.Serial.touchForCDCReset(Serial.java:81)
	... 7 more
`

I close the Serial Monitor, after I close also the IDE arduino, but nothing the error is port busy...
I have to turn-off the power to board and after turn-on it...
thanks

oscaroxy, 2016-05-16:
How I resolve this?
This is invalidate for me, every time I have to turn-off and after turn-on the power ...
thanks

ZdenekAster, 2016-05-16:
If you try unconnect and connect usb cable, resolve this problem too?

oscaroxy, 2016-05-16:
sometime, no always ... but why does this? is there a way in order to solve this?
How do you program it?

ppescher, 2016-05-17:
Looks like it may be an issue related to MacOSX.
If you have Windows, please try the same procedure and see if it works for you.

oscaroxy, 2016-05-18:
Today I tried with virtualbox, but the usb don't work, it always is busy... I'll try with windows pc...
in the meantime thanks

oscaroxy, 2016-06-02:
Hi, I would to use gsm.h library so I can to use the example of arduino. But When I include GSM.h and I compile receive the error:
WARNING: the GSM library claims to work on [avr] architectures and may not be compatible with your card that uses the architecture [sam]...
thanks _______________________________________________________________________
Oscar OXY

      Da: Paolo Messina <notifications@github.com>
 A: geolink/opentracker <opentracker@noreply.github.com>
Cc: oscaroxy <scriviaoscar@yahoo.it>; Author <author@noreply.github.com>
 Inviato: Martedì 17 Maggio 2016 9:54
 Oggetto: Re: [geolink/opentracker] Method name - openPort(); Exception type - Port busy (#53)

Looks like it may be an issue related to MacOSX.
If you have Windows, please try the same procedure and see if it works for you.—
You are receiving this because you authored the thread.
Reply to this email directly or view it on GitHub

ppescher, 2016-06-02:
If that is a warning you should be able to continue and still use the library.
You should complain with the GSM library authors about this warning message.
There is nothing we can do.

oscaroxy, 2016-06-03:
Hi, I would to use gsm.h library so I can to use the example of arduino. But When I include GSM.h and I compile receive the error:

/Applications/Arduino.app/Contents/Java/libraries/GSM/src/GSM3SoftSerial.cpp:129:2: error: #error This version of GSM3SoftSerial supports only 20, 16 and 8MHz processors
 #error This version of GSM3SoftSerial supports only 20, 16 and 8MHz processors

other the warning:

WARNING: the GSM library claims to work on [avr] architectures and may not be compatible with your card that uses the architecture [sam]...

thanks for your patience

ps: is opentracker 100% compatible with arduino? Why this base library don't work fine?

ZdenekAster, 2016-06-03:
Opentracker is compatible with Arduino DUE but use cpu with less ram and pins.
Arduino due (ARM 32bit ) have different architecture from arduino uno (AVR 8bit)
GSM library is different for GSM chip, SIM900, QUECTEL M95, base commands are same, but ip stack is different. Your error use gsm wich use library software serial. Software serial most often on arduino uno... You can use gsm library from opent tracker.

oscaroxy, 2016-06-03:
thanks for your complete reply, but where is an example of gsm library from open tracker? I would to do a simple call http (gprs datas/datas traffic), that is I would send lat & long to my server (send to https://myserver.com?lat=41.021221&log=1.234495959)

thanks a lot

ZdenekAster, 2016-06-03:
Yes gsm is in gsm.ino. Easiest way is modify tracker.h, where is define hostname and include information to send, but opentracker use POST data define here https://geolink.io/configure.php,

JuniorEC, 2017-08-23:
Hello everyone, make sure there is no other program using or using an indirect way of communication, in case you have to use this port, create a rule to use one at a time.

Closed 2016-06-02.

Thread 54 (2016-05-15):

Serial.println don't work

oscaroxy, 2016-05-15:
Why  Serial.println don't work than debug.println yes and why if I do:

`
void setup() {

  //setup led pin
  pinMode(PIN_POWER_LED, OUTPUT); // Set LED as Output
  digitalWrite(PIN_POWER_LED, LOW); // Set LED initially off
  Serial.begin(9600);
   debug_print("setup");
   Serial.println("Serial setup");
}
`

none string are print into monitor serial, why?
thanks

oscaroxy, 2016-05-15:
maybe I have to install: SoftwareSerial ?
Where Do I find that library and How Do I install it?

thanks

ZdenekAster, 2016-05-15:
In main program is in
#define gps_port Serial1
#define debug_port SerialUSB
#define gsm_port Serial2

You have to write
SerialUSB.begin(9600)
debug_print("Setup);  // or SerialUSB.println("Setup");

oscaroxy, 2016-05-15:
Unfortunately it don't work, I done:

`int ii=0;
void setup()
{
  debug_port.begin(9600);
  ii++;
  debug_port.println(ii );

  pinMode(PIN_POWER_LED, OUTPUT); // Set LED as Output
  digitalWrite(PIN_POWER_LED, LOW); // Set LED initially on
}

void loop(){
 ii++;
  debug_port.println(ii );
}
`

the led turn-on, but in serial monitor I see the ii=4,ii=5,ii=6,etc... but it don't start from 1.... why?????
thanks in order to patience :-)

ZdenekAster, 2016-05-15:
Try command delay(2000);  before debug_port.being(9600);

oscaroxy, 2016-05-16:
yes, so work, because slow down ... this mean that the usb reply a message slow than the setup procedure.
The arduino uno reply the Serial.print in setup procedure correctly, why that board no?
thanks

ZdenekAster, 2016-05-16:
Open track is the same as Arduino due, is different from uno, This boards have two usb modes. I think  when change mode after programming to serial,  windows lost few first serial chars. Try less delay for work. It think that 500ms be enough

oscaroxy, 2016-05-16:
thanks

Closed 2016-05-16.

Thread 55 (2016-06-21):

Board version 1.0.3 fixes Serial3 pin definition, but not appearing in IDE

VernonBreet, 2016-06-21:
There was a problem with the pin definitions for Serial3, for which a new URL for board manager, was provided. I can't see the version 1.0.3 fix in the IDE though, and I can now not compile previously working code.

ppescher, 2016-06-21:
Branch 1.0.3 of https://github.com/geolink/opentracker-arduino-board provides support for the next board hardware revision 2.4
You have an option in the IDE Tools menu to choose your board revision.
Even when you choose revision 2.3 (and earlier) the old sketches may have build errors, which have been addressed in current master branch of https://github.com/geolink/opentracker

If you want to keep your old sketch, you can patch version 1.0.2 of the board support package manually to fix Serial3.
Open the file "variant.cpp", that you can find in "%LocalAppData%\Local\Arduino15\packages\opentracker\hardware\sam\1.0.3\variants\geolink_opentracker" on your PC (if that doesn't work, try %AppData%).
And replace **PIO_PERIPH_B** with **PIO_PERIPH_A** at lines 202-203, as below:
```
  // 42 - USART3 (Serial3) all pins
  { PIOB, PIO_PB20A_TXD2|PIO_PB21A_RXD2, ID_PIOB, PIO_PERIPH_A, PIO_DEFAULT, (PIN_ATTR_DIGITAL|PIN_ATTR_COMBO), NO_ADC, NO_ADC, NOT_ON_PWM, NOT_ON_TIMER },
```

VernonBreet, 2016-06-21:
Thank ypu, I have re-done everything, but still get an error, even when I select board version 2.3:
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
I will try a manual patch next, and let you know.

ppescher, 2016-06-21:
That error might be caused by the old version 1.0.2 still present on disk.
The IDE sometimes fails to delete the folder that contains the old version (try to remove "%LocalAppData%/Arduino15/packages/opentracker/hardware/sam/1.0.2" manually)

VernonBreet, 2016-06-21:
The manual patch worked, thank you.

Closed 2016-06-21.

Thread 56 (2016-06-30):

Arduino IDE integration files for 1.0.3

Daniel-dk, 2016-06-30:
Using Arduino IDE 1.6.9
Windows 10

Following the IDE integration instructions from https://github.com/geolink/opentracker-arduino-board which points to the master branch only lists up to 1.0.2

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

when installing 1.0.3 by directly [referencing its json file](https://raw.githubusercontent.com/geolink/opentracker-arduino-board/1.0.3/package_opentracker_index.json) there seems to be some information missing and compilation fails.

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

ppescher, 2016-06-30:
Make sure you uninstalled the old version.
Check if you have some left-over from the previous version in your folder: %LocalAppData%\Arduino15\packages\opentracker (on Windows)
In particular, under "opentracker\hardware\sam" there should be only one folder named "1.0.3"

FYI: The new version will be soon merged into the master branch. That should facilitate upgrading (but I've seen some IDE versions still failing to clean up properly).

Daniel-dk, 2016-06-30:
That was the issue,
There were some directories left over in 1.0.2 with "NUL" files in them - probably form an incomplete removal.

after removing 1.0.2 from the arduino packages the IDE successfully uses 1.0.3

Closed 2016-06-30.

Thread 57 (2016-07-03):

Cant't work with 1-wire on internal extension connector

varlux, 2016-07-03:
Hello, what is the name of the pins on the internal extension connector? I cant't communicate with my 1-wire sensor on "PIN_EXT_PA23".

Thanks

Daniel-dk, 2016-07-04:
Do you have a gist / pastebin where we could look at you code or test it on our boards ?

varlux, 2016-07-04:
Oh....yes...very simple code

`#include <OneWire.h>

OneWire ow(PIN_EXT_PA23);

byte owaddr[8];

void setup() {
  SerialUSB.begin(9600);
}

void loop() {

  if (ow.search(owaddr)) {
    SerialUSB.println(F("OK, I can found it!"));
    ow.reset_search();
  }
  else {
    SerialUSB.println(F("mmmm...no, it isn't working"));
  }
  delay(1000);
}`

Thank you Daniel

Daniel-dk, 2016-07-05:
`#include OneWire.h` should probably be `#include <OneWire.h>`
I could still not get your code ( or the oneWire library ) to flip the pin.. maybe there is some more setup needed that Dallas temperature does for us ?

I had some luck with the DallasTemperature library but I think my DS18B20 sensor is fried.. so one can only see the bits flipping but no data.
one can see the pin toggling, but no reply from the DS18B20- I think its fried, but I don't have another to test with..

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

I used this code : http://pastebin.com/6c4aYkck

varlux, 2016-07-05:
Hi Daniel,

     thanks for your time. I thing I am inaccurate......excuse me.

The library I use is a [PaulStoffregen's library](https://github.com/PaulStoffregen/OneWire) create for Arduino IDE, and the simple code I wrote works fine in Arduino UNO.

Why this library doesn't work on OpenTracker?!?

Thanks

ppescher, 2016-07-05:
Probably due to this line:
https://github.com/PaulStoffregen/OneWire/blob/master/OneWire.h#L94

And possibly other places where only SAM3X8E is considered.
OpenTracker uses SAM3A4C (and SAM3A8C in early prototypes).

PaulStoffregen, 2016-07-06:
I do not have this hardware, and even if I did have it here, I probably could not spend engineering time to test it.

Please feel free to investigate this problem. When/if you find a solution (even just adding to the ifdef check), submit a pull request. Your changes should be limited to the hardware defines in OneWire.h.

This is how open source works. The OneWire library is designed to be adapted to other hardware by editing just those defines. As the maintainer of this library, I depend on community contributions to add the defines for hardware I do not personally own or support.

ppescher, 2016-07-06:
@varlux I guess you can just change that line from:
```
#elif defined(__SAM3X8E__)
```
To:
```
#elif defined(__SAM3X8E__) || defined(__SAM3A8C__) || defined(__SAM3A4C__)
```
They are essentially the same hardware family, often referenced as [SAM3XA](http://asf.atmel.com/docs/3.0.1/sam.drivers.spi.example.sam3x_ek/html/sam3xa_8h_source.html), so I think it should work. But I don't have OneWire devices to test it.

PaulStoffregen, 2016-07-06:
http://www.digikey.com/product-detail/en/maxim-integrated/DS18B20-/DS18B20--ND/956983

PaulStoffregen, 2016-07-06:
Please only submit a pull request *after* you have verified it works on your hardware.

ppescher, 2016-07-07:
@varlux I tested the patched OneWire library with OpenTracker HW rev 2.3 and a Dallas/Maxim temperature sensor chip DS18S20, powered at 3.3V and attached to pin PA23 with 4k7 pull-up resistor. It works fine.

varlux, 2016-07-07:
Grande Paoluccio!

I will test the patched OneWire library with my old Tigal OpenTracker and chip DS18B20 very soon.

varlux, 2016-07-21:
OK. I tried the patched library with old Tigal Opentracker (SAM3A4C).
It works fine.
Thank you all for your valuable time.

Closed 2016-07-21.

Thread 58 (2016-07-14):

How do I know which Hardware version I have?

VernonBreet, 2016-07-14:

ppescher, 2016-07-15:
The hardware revision is printed on the board silkscreen, in the bottom right corner, near the GPS antenna.

Sample of revision 2.3
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

Sample of revision 2.4
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

VernonBreet, 2016-07-15:
Thank you.

Closed 2016-07-15.

Thread 59 (2016-07-17):

Is it possible to change the setup of the QuectelL76?

ramunter, 2016-07-17:
The gps module supports a 10hz update rate and 115200 BAUD rate but the default settings are 1 hz and 9600 BAUD. Is there anyway to change these through the OpenTracker board?

ppescher, 2016-07-18:
Yes. You can modify the firmware using Arduino IDE.
The modified firmware should configure the GPS according to your needs.
You can get the L76 serial protocol from Quectel: http://www.quectel.com/UploadImage/Downlad/Quectel_L76_Series_Protocol_Specification_V2.0.pdf
Look for packet PMTK_SET_NMEA_BAUDRATE and PMTK_SET_POS_FIX (updated docs say minimum interval is 100ms => 10Hz)

Closed 2017-04-05.

Thread 60 (2016-07-17):

for inspiration update firmware over http

ZdenekAster, 2016-07-17:
I do not have more time for comment and create clearly code, but it is good function.
It would be a shame to share it. Sorry for my English.

On web is script which add bootloader (folder uflash) to binary my software for opentracker( Carunit_1_1), this script send binary as more block hex.
Opentracker get http get for every page and store over 128kB when get all change boot from section 1 and reboot. in section 1 now is downloaded bootloder with software bootloader reflash section 0 and change boot to section 0.

In carunit is interesting function wich set gprs parametrs from operator network code.
And function for get credit from prepaid sim card.

Software attached it is not complete because complex and web code for view trackers, but for include firmware update over http for own application is all that you need.
Software assume correct DueFlashStorage for access to both bank wich last parameter select bank.
[Export.zip](https://github.com/geolink/opentracker/files/367910/Export.zip)

Zdenek Aster

VernonBreet, 2016-07-18:
Good job, Zdenek! Busy checking it out now.

ZdenekAster, 2016-07-18:
I forget modified files opentracker define, where is change of linker script address for bootloader to boot section 1. In this attachment.
[opentracker.zip](https://github.com/geolink/opentracker/files/369135/opentracker.zip)
In arduino displaay Opentracker and Opentracker2 with modifed linker. I modified version 1.0.2 replace define file with this attachment, for newer version it probably will not work.

varlux, 2016-11-12:
Wow..... where I can find information?

ZdenekAster, 2016-11-12:
In first post is file export.zip, This code assume web support, but complete idea is in code. The code is cut from my project, but some notes and variables in czech, when i will have more time i am try tu rewrite clearly code, but for programmer is not problem use and modify for your application. In export.zip is all what you need.

varlux, 2016-11-19:
I am not a programmer, but I am very interested to this function. So, I will try learn it....with your help. Firstly I have to understand the procedure to reset  and erase the flash, and then how to program it "OTA".
By Arduino DUE's web page I know that is necessary to erase the flash before programm it, because in this case the board is started with the bootloader in the ROM memory.
Probably I have to use "erase" PIN, but this PIN is not connected to any others in openTracker.....
So, the first question is: How can I erase the flash in OpenTracker from a remote application? Which pins I have to use?

Thanks in advance

varlux, 2016-11-20:
Ok...ok... I am not a programmer and I need to understand "step by step".
I am studying your code, openTracker's pcb and processor datasheet......
So I understand that you firstly download new code (and "bootloader") in flash1, select boot from flash1 and reboot by C_REBOOT pin.
After reboot, the new "bootloader" in flash1 copies new code in flash0, select boot from flash0 and reboot.
Now firmware is update.

IS IT CORRECT ??

If so, I would like to ask you if I can test this procedure on my desk via serial port......
In detail, I want write a script that accepts data from serial port. After a specific command, I will send a compiled file. The script will copies this file in flash1 byte-to-byte thanks to DueFlashStorage library, select boot from flash1 and reboot.....

Can it works???

varlux, 2016-11-20:
Ops.... another question: where is C_REBOOT pin in version 2.4 ?!?

Thread 61 (2016-07-19):

Builtin antennas

cristianormoraes, 2016-07-19:
Why not builtin GSM and GPS antennas?

regards,

Cristiano

Daniel-dk, 2016-09-05:
in some cases its easier to mount the device in the lower body of a vehicle and run antennae to a place where they can see the sky, there are units ( not OpenTracker ) that use internal antennae and are mounted in other areas of the vehicle so one cannot trace an antenna cable back to the unit.

trackers for "Telemetry" are different to trackers made for "Recovery"

Closed 2017-04-05.

Thread 62 (2016-08-02):

Can't add OpenTracker Board V1.0.3 with board manager (Arduino IDE)

varlux, 2016-08-02:
These are the errors when I try to add the board:
----------------------------------------------------------------------------------------------------------------------------
Errore durante lo scaricamento di https://github.com/geolink/opentracker-bossa/releases/download/1.5-opentracker/bossac-1.5-opentracker-x86_64-pc-linux-gnu.tar.gz
java.lang.RuntimeException: java.lang.Exception: Errore durante lo scaricamento di https://github.com/geolink/opentracker-bossa/releases/download/1.5-opentracker/bossac-1.5-opentracker-x86_64-pc-linux-gnu.tar.gz
	at cc.arduino.contributions.packages.ui.ContributionManagerUI.lambda$onInstallPressed$20(ContributionManagerUI.java:176)
	at java.lang.Thread.run(Thread.java:745)
Caused by: java.lang.Exception: Errore durante lo scaricamento di https://github.com/geolink/opentracker-bossa/releases/download/1.5-opentracker/bossac-1.5-opentracker-x86_64-pc-linux-gnu.tar.gz
	at cc.arduino.contributions.DownloadableContributionsDownloader.download(DownloadableContributionsDownloader.java:113)
	at cc.arduino.contributions.DownloadableContributionsDownloader.download(DownloadableContributionsDownloader.java:67)
	at cc.arduino.contributions.packages.ContributionInstaller.install(ContributionInstaller.java:111)
	at cc.arduino.contributions.packages.ui.ContributionManagerUI.lambda$onInstallPressed$20(ContributionManagerUI.java:173)
	... 1 more
Caused by: java.io.IOException: Received invalid http status code from server: 404
	at cc.arduino.utils.network.FileDownloader.downloadFile(FileDownloader.java:194)
	at cc.arduino.utils.network.FileDownloader.download(FileDownloader.java:128)
	at cc.arduino.contributions.DownloadableContributionsDownloader.download(DownloadableContributionsDownloader.java:111)
	... 4 more
-------------------------------------------------------------------------------------------------------------------------------
Give me a hint, please!
Thanks

ppescher, 2016-08-03:
There was a typo in the download URL (404) in package index. It should be fixed now in the master branch.

varlux, 2016-08-03:
OK, it works.

Thank you Paolo

Closed 2016-08-03.

Thread 64 (2016-09-05):

upload issues ( USB ) when a device is attached to EXT_RX and EXT_TX

Daniel-dk, 2016-09-05:
we have an expansion shield on the Opentracker ( rev 2.3 ) with a device on EXT_RX and EXT_TX ( Arduino "Serial" )

I know the bootloader listens on the UART0 ( Arduino "Serial" / EXT_TX ,EXT_RX ) and USB for new code, when we have a device is attached to those pins it seems to interfere with the upload process even if only USB is used.

The board  "gets stuck" and we have to detach the shield, re-do the flash erase with the ERASE pin, upload and re-attach the shield.

do you know how we could get around this ?

I think this is more a SAMBA issue than a OpenTracker issue but useful to know about for anyone that wants to attach other serial devices to OpenTracker

 * rather use EXT_RXD2 and EXT_TXD2 - Arduino "Serial3"

haxyn, 2016-09-06:
Hi,

Not sure if it's related, but I have similar problem.
I use EXT_SDA and EXT_SCL for I2C and EXT_21-23 for encoder.
Work perfect on Win7Pro, but on other machine with Win10Pro I have to use ERASE pin every second upload.

ppescher, 2016-09-06:
@Daniel-dk If something is connected to the boot UART, you should make sure that the serial line is idle at reset.

When the Arduino IDE opens the USB-Serial port at 1200 baud, then closes the port, the Arduino core libraries running on the board will reset the device to enter the ROM bootloader (SAM-BA).
This code will check both USB and UART in a loop, to see which one is connected first:
- if USB enumeration starts (connection to a PC) then the USB channel will be used
- if anything is received on the UART, then only that channel will be used

So make sure pin ETX_RX is always high (idle) at reset. If the rise time of this line is too slow, you might need to delay the nRESET rising edge, so that EXT_RX has time to reach the idle state before the boot program starts.

Please note the EXT_RX line should stay idle until the USB enumeration, which may take some time since reset (hundreds of milliseconds, or more, depending on the PC). If you have some other device that starts transmitting on the EXT_RX line, make sure it will delay the first transmission by the appropriate amount of time.

@haxyn I don't think this is related to your problem. The pins you are using should not conflict with the boot monitor.

Hope this helps,
Paolo

Closed 2016-09-12.

Thread 66 (2017-02-03):

3G Board - Failed auto-baudrate & +CME Error: 4

alskyline, 2017-02-03:
Here in USA, some of the major carriers are dropping their 2G service. This forced me to upgrade to the new 3G boards. The modem is having trouble connecting to the cellular network. I have attached a .txt file with the debug output. I have switched cellular carriers and my old 2G Opentrackers connect just fine. This seems to be only a problem with the new 3G boards.

Please Help.

[Debug output.txt](https://github.com/geolink/opentracker/files/750528/Debug.output.txt)

ppescher, 2017-02-03:
Are you using factory programmed firmware or did you re-program the boards yourself?

If you reprogram the boards with the firmware available here on GitHub, make sure you have the latest board support package from https://github.com/geolink/opentracker-arduino-board and you select Board Version: OpenTracker 3G in the Tools menu of your Arduino IDE.

Please also note the last IDE version known to work with OpenTracker is 1.6.13 at this date.

ppescher, 2017-04-05:
I have tested Arduino IDE 1.8.1 with OpenTracker software without any issue.
Can you update the status of this issue?

Closed 2017-04-05.

Thread 67 (2017-03-13):

CAN Bus not work.......

Jason0416, 2017-03-13:
I Try the CAN Bus use the example program "CAN_TrafficSnooper.ino" in the <due_can> library. But not any response. Use the oscilloscope to check the CAN bus, Everything is OK.............

Jason0416, 2017-03-13:
Oh..........no................ I Have to <due_can.h> library, One from opentracker board manager and one from Mr.somebody. Keep OpenTracker's library, Everything is OK.

Closed 2017-03-13.

Thread 68 (2017-04-10):

Open Tracker - failed auto-baudrate error

haroon-rehman, 2017-04-10:
Hi,
After couple of days of working my open tracker gives me only one message on serial port "ailed auto-baudrate error" and after 4 or 5 retry attempts it stops gsm connection. What can cause this and how to fix it. I have attached image of what i see on serial monitor.

Thanks for any help offered.

Regards,
Haroon
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

haroon-rehman, 2017-04-10:
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

ppescher, 2017-04-10:
Try to add the following code after https://github.com/geolink/opentracker/blob/master/OpenTracker/gsm.ino#L62
`debug_print("read status");`

Just before the line that starts with "return".

Your code should look like:
```
#if MODEM_UG96
  // inverted status signal
  debug_print("read status");
  return digitalRead(PIN_STATUS_GSM) != HIGH;
#else
```

Load the modified sketch and check if you can see the message "read status" in the serial log.

haroon-rehman, 2017-04-11:
Hi Paolo,

Yes I can see the 'read status' message in the logs.

[cid:eebaf623-b8b4-49b1-87e8-c9e80ea20caf]

Regards,

Haroon

Orion Systems

________________________________
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

haroon-rehman, 2017-04-11:
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

ppescher, 2017-04-11:
Stupid question, but I must ask: are you sure you have the 3G modem on your board?
You should see "Quectel UG96" written on the top white label.

If this is actually an UG96 (3G) then the modem is not starting up (STATUS pin never goes high). Which is confirmed by the green LED always off.

There might be several causes to that. First, please check your power input: if the input voltage is too low or the current provided by your power source is not enough, the modem will not start.

If you have a Voltmeter and some spare male headers or solid wires, you can probe the following voltages on the expansion connector:

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

Please report your readings, along with your power source voltage/current rating.

haroon-rehman, 2017-04-11:
Hi Paolo,
It is a UG96 chip.
The power adapter used is 12VDC, 1500 mA. The tracker worked on it for almost 2 days before i started getting this problem
The voltages on the expansion connector are same as indicated in your pics. I have attached some images below;
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

ppescher, 2017-04-11:
Voltages are correct, also power supply rating is fine.

Could you try to power on the device without the SIM card?
And check the serial log and the green LED.

haroon-rehman, 2017-04-11:
Hi mate,
Its still the same. No green light. See the image below.

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

Codematic, 2017-08-21:
Any final solution for this? I have the same issue which appeared after first flash try.

ppescher, 2017-08-22:
Here the modem did not reply at all, your case is different. See https://github.com/geolink/opentracker/issues/72

Closed 2017-08-22.

Thread 72 (2017-08-21):

Can not connect to remote server:  updates.geolink.io Modem Reply: +CEER: "No report available" Modem Reply: +CME ERROR: 4

Codematic, 2017-08-21:
I have serious problems to program OpenTracker. I have tried several source codes (3.1.1, 3.1.2 and 3.1.3) but non of those seems to work properly. Also tried to consider to have correct board support package for each of those source code packages (1.0.3 vs. 1.0.4). But that did not help either. Hope some of you have quick solution to this issue.

The board should be 3G version (HW rev 2.4C).
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

To make sure, I have used this setup with factory firmware more than 2 months and also same power supply were just fine for couple of hours with factory firmware.
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

Could there be something I have missed while creating tracker.h? (something to define more?)

Also same SIM card is used before without problems.

Is there something else I could try to modify to sort out this issue?

Btw, should all of those source code packages work with this board?

Here is log of issues with the 3.1.2 package:
```
setup() started
settings_load() started
settings_load(): First run flag:
255
settings_load(): setting defaults from config
settings_load(): set config.interval:
10000
internet
settings_save() started
settings_save() finished
settings_load(): config.interval:
10000
settings_load(): config.interval_send:
1
settings_load(): config.powersave:
0
settings_load() finished
store_get_index() started
store_get_index(): Not found, initialize log position:
1024
store_get_index() ended
gps_setup() started
gps_on() started
gps_on() completed
$PMTK011,MTKGPS*08
$PMTK010,001*2E
$PMTK011,MTKGPS*08
$PMTK010,002*2D
gps_setup() completed
gsm_setup() started
gsm_off() started
gsm_off() finished
gsm_on() started
gsm_send_at() started
gsm_send_at() completed
0
gsm_on(): failed auto-baudrate
gsm_off() started
Modem Reply:

RDY

gsm_off() finished
gsm_off() started
gsm_off() finished
gsm_on(): try again
1
gsm_send_at() started
Modem Reply:

OK

Modem Reply:

OK

Modem Reply:

OK

Modem Reply:

OK

Modem Reply:

OK

gsm_send_at() completed
0
gsm_on(): failed auto-baudrate
gsm_off() started
gsm_off() finished
gsm_off() started
gsm_off() finished
gsm_on(): try again
2
gsm_send_at() started
Modem Reply:

OK

Modem Reply:

OK

Modem Reply:

OK

Modem Reply:

OK

Modem Reply:

OK

gsm_send_at() completed
0
gsm_on(): failed auto-baudrate
gsm_off() started
gsm_off() finished
gsm_off() started
gsm_off() finished
gsm_on(): try again
3
gsm_send_at() started
Modem Reply:

OK

Modem Reply:

OK

Modem Reply:

OK

Modem Reply:

OK

Modem Reply:

OK

gsm_send_at() completed
0
gsm_on(): failed auto-baudrate
gsm_off() started
gsm_off() finished
gsm_off() started
gsm_off() finished
gsm_on(): try again
4
gsm_send_at() started
Modem Reply:

OK

Modem Reply:

OK

Modem Reply:

OK

Modem Reply:

OK

Modem Reply:

OK

gsm_send_at() completed
0
gsm_on(): failed auto-baudrate
Modem Reply:

Modem Reply:
OK

Modem Reply:

Modem Reply:
OK

gsm_on() finished
gsm_set_pin() started
Modem Reply:

Modem Reply:
+CPIN: READY

Modem Reply:

Modem Reply:
OK

Warning: timed out waiting for last modem reply
Warning: timed out waiting for last modem reply
Modem Reply:

Modem Reply:
+CPIN: READY

Modem Reply:

Modem Reply:
OK

Warning: timed out waiting for last modem reply
Warning: timed out waiting for last modem reply
Modem Reply:

Modem Reply:
+CPIN: READY

Modem Reply:

Modem Reply:
OK

Warning: timed out waiting for last modem reply
Warning: timed out waiting for last modem reply
Modem Reply:

Modem Reply:
+CPIN: READY

Modem Reply:

Modem Reply:
OK

Warning: timed out waiting for last modem reply
Warning: timed out waiting for last modem reply
Modem Reply:

Modem Reply:
+CPIN: READY

Modem Reply:

Modem Reply:
OK

Warning: timed out waiting for last modem reply
Warning: timed out waiting for last modem reply
gsm_set_pin() completed
gsm_get_modem_status() started
Modem Reply:

Modem Reply:
+CPAS: 0

Modem Reply:

Modem Reply:
OK

gsm_get_modem_status() returned:
0
gsm_get_imei() started
Modem Reply:

865789021843729

OK

gsm_get_imei() result:
B
gsm_get_imei() completed
gsm_startup_cmd() started
Modem Reply:

Modem Reply:
OK

Modem Reply:

Modem Reply:
+CME ERROR: 4

Modem Reply:

Modem Reply:
OK

gsm_startup_cmd() completed
gsm_set_apn() started
Modem Reply:

Modem Reply:
ERROR

Modem Reply:

Modem Reply:
+CME ERROR: 4

Modem Reply:

Modem Reply:
ERROR

Modem Reply:

Modem Reply:
+CME ERROR: 4

Modem Reply:

Modem Reply:
ERROR

Modem Reply:

gsm_send_at() started
Modem Reply:
+CME ERROR: 4

OK

Modem Reply:

OK

Modem Reply:

OK

Modem Reply:

OK

Modem Reply:

OK

gsm_send_at() completed
0
gsm_set_apn() completed
gsm_setup() completed
setup() completed
sms_check() started
Modem Reply:

Modem Reply:
OK

Warning: timed out waiting for last modem reply
Deleting READ and SENT SMS
Modem Reply:

Modem Reply:
ERROR

Modem Reply:

Modem Reply:
ERROR

sms_check() completed
Ignition status:
0
Ignition is ON!
collect_all_data() started
gsm_get_time() started
Modem Reply:

+CCLK: "17/08/21,19:37:00+12"

OK

gsm_get_time() result:
17/08/21,19:37:00+12
gsm_get_time() completed
$GNRMC,193343.426,A,6110.8872,N,02141.2018,E,0.33,345.45,210817,,,A*7F
Invalid altitude, retrying.

$GPVTG,345.45,T,,M,0.33,N,0.61,K,A*39
$GPGGA,193343.426,6110.8872,N,02141.2018,E,1,5,4.40,32.0,M,21.1,M,,*6B4,272,31,87,27,340,,69,23,101,,85,05,225,*6F
$GLGSV,3,3,09,73,02,168,*55
1,11,037,33,44,11,132,,29,09,006,28*79
$GLGSV,3,1,09,70,81,085,,71,43,286,28,79,41,044,25,80,41,134,22*6D
$GLGSV,3,2,09,86,33,271,28,87,28,338,38,69,22,102,17,85,04,225,*6D
$GLGSV,3,3,09,73,03,168,18*5D
$GNGLL,6110.8417,N,02141.1700,E,193700.000,A,A*47
$GNRMC,193701.000,A,6110.8417,N,02141.1700,E,0.00,351.76,210817,,,A*7A
Invalid altitude, retrying.

$GPVTG,351.76,T,,M,0.00,N,0.00,K,A*3B
$GPGGA,193701.000,6110.8417,N,02141.1700,E,1,15,0.71,34.0,M,21.1,M,,*5A
GPS fix received.
Data is current.
Current time set from GPS time:
17/08/21,19:37:01+00
gsm_set_time() started
Modem Reply:

Modem Reply:
OK

gsm_set_time() completed

GPS already available, breaking
collect_gps_data(): fix acquired
Failed checksums:
3
collect_all_data() completed
Current:
17/08/21,19:37:00+12[210817,19370100,61.180695,21.686167,0.00,34.00,351.76,71,15]

gsm_send_at() started
Modem Reply:

OK

Modem Reply:

OK

Modem Reply:

OK

Modem Reply:

OK

Modem Reply:

OK

gsm_send_at() completed
0
gsm_disconnect() started
Modem Reply:

Modem Reply:
ERROR

gsm_disconnect() completed
gsm_connect() started
gsm_get_modem_status() started
Modem Reply:

Modem Reply:
+CPAS: 0

Modem Reply:

Modem Reply:
OK

gsm_get_modem_status() returned:
0
gsm_get_connection_status() started
Modem Reply:

Modem Reply:
+CME ERROR: 4

gsm_get_connection_status() returned:
-1
Modem Reply:

Modem Reply:
ERROR

Connecting to remote server...
0
Modem Reply:

Modem Reply:
ERROR

Can not connect to remote server:
updates.geolink.io
Modem Reply:

Modem Reply:
+CEER: "No report available"

Modem Reply:

Modem Reply:
OK

gsm_get_modem_status() started
Modem Reply:

Modem Reply:
+CPAS: 0

Modem Reply:

Modem Reply:
OK

gsm_get_modem_status() returned:
0
gsm_get_connection_status() started
Modem Reply:

Modem Reply:
+CME ERROR: 4

gsm_get_connection_status() returned:
-1
Modem Reply:

Modem Reply:
ERROR

Connecting to remote server...
1
Modem Reply:

Modem Reply:
ERROR

Can not connect to remote server:
updates.geolink.io
Modem Reply:

Modem Reply:
+CEER: "No report available"

Modem Reply:

Modem Reply:
OK

gsm_get_modem_status() started
Modem Reply:

Modem Reply:
+CPAS: 0

Modem Reply:

Modem Reply:
OK

gsm_get_modem_status() returned:
0
gsm_get_connection_status() started
Modem Reply:

Modem Reply:
+CME ERROR: 4

gsm_get_connection_status() returned:
-1
Modem Reply:

Modem Reply:
ERROR

Connecting to remote server...
2
Modem Reply:

Modem Reply:
ERROR

Can not connect to remote server:
updates.geolink.io
Modem Reply:

Modem Reply:
+CEER: "No report available"

Modem Reply:

Modem Reply:
OK

gsm_connect() completed
gsm_disconnect() started
Modem Reply:

Modem Reply:
ERROR

gsm_disconnect() completed
Error, can not send data or no connection.
Can not send data, saving to flash memory
storage_save_current() started
storage_save_current() ended
storage_send_logs() started
storage_send_logs(): Found log sent position:
1024
storage_send_logs(): Sending data from:
1024
Log data:
17/08/21,19:37:00+12[210817,19370100,61.180695,21.686167,0.00,34.00,351.76,71,15]

gsm_send_at() started
Modem Reply:

OK

Modem Reply:

OK

Modem Reply:

OK

Modem Reply:

OK

Modem Reply:

OK

gsm_send_at() completed
0
gsm_disconnect() started
Modem Reply:

Modem Reply:
ERROR

gsm_disconnect() completed
gsm_connect() started
gsm_get_modem_status() started
Modem Reply:

Modem Reply:
+CPAS: 0

Modem Reply:

Modem Reply:
OK

gsm_get_modem_status() returned:
0
gsm_get_connection_status() started
Modem Reply:

Modem Reply:
+CME ERROR: 4

gsm_get_connection_status() returned:
-1
Modem Reply:

Modem Reply:
ERROR

Connecting to remote server...
0
Modem Reply:

Modem Reply:
ERROR

Can not connect to remote server:
updates.geolink.io
Modem Reply:

Modem Reply:
+CEER: "No report available"

Modem Reply:

Modem Reply:
OK

gsm_get_modem_status() started
Modem Reply:

Modem Reply:
+CPAS: 0

Modem Reply:

Modem Reply:
OK

gsm_get_modem_status() returned:
0
gsm_get_connection_status() started
Modem Reply:

Modem Reply:
+CME ERROR: 4

gsm_get_connection_status() returned:
-1
Modem Reply:

Modem Reply:
ERROR

Connecting to remote server...
1
Modem Reply:

Modem Reply:
ERROR

Can not connect to remote server:
updates.geolink.io
Modem Reply:

Modem Reply:
+CEER: "No report available"

Modem Reply:

Modem Reply:
OK

gsm_get_modem_status() started
Modem Reply:

Modem Reply:
+CPAS: 0

Modem Reply:

Modem Reply:
OK

gsm_get_modem_status() returned:
0
gsm_get_connection_status() started
Modem Reply:

Modem Reply:
+CME ERROR: 4

gsm_get_connection_status() returned:
-1
Modem Reply:

Modem Reply:
ERROR

Connecting to remote server...
2
Modem Reply:

Modem Reply:
ERROR

Can not connect to remote server:
updates.geolink.io
Modem Reply:

Modem Reply:
+CEER: "No report available"

Modem Reply:

Modem Reply:
OK

gsm_connect() completed
gsm_disconnect() started
Modem Reply:

Modem Reply:
ERROR

gsm_disconnect() completed
Error, can not send data or no connection.
storage_send_logs(): Error sending logs
storage_send_logs() ended
Sleeping for:
-118040
ms
Error: negative sleep time.
sms_check() started
Modem Reply:

Modem Reply:
OK

Warning: timed out waiting for last modem reply
Deleting READ and SENT SMS
Modem Reply:

Modem Reply:
ERROR

Modem Reply:

Modem Reply:
ERROR

sms_check() completed
Ignition status:
0
Ignition is ON!
collect_all_data() started
gsm_get_time() started
Modem Reply:

+CCLK: "17/08/21,19:39:08+00"

OK

gsm_get_time() result:
17/08/21,19:39:08+00
gsm_get_time() completed
$GNGSA,A,3,03,06,26,22,31,02,29,23,09,,,,1.08,0.71,0.81*18
$GNGSA,A,3,69,87,71,79,80,86,,,,,,,1.08,0.71,0.81*14
$GPGSV,3,1,12,23,75,122,31,09,65,228,39,06,47,258,33,03,34,133,23*7E
$GPGSV,3,2,12,02,28,312,25,26,23,070,31,07,14,189,16,16,13,098,19*7D
G42,133,18,79,41,043,20*6D
$GLGSV,3,2,10,86,32,270,36,87,28,337,39,69,21,102,,73,05,168,*63
$GLGSV,3,3,10,85,03,225,,88,01,014,*6B
$GNGLL,6110.8417,N,02141.1700,E,193908.000,A,A*41
$GNRMC,193909.000,A,6110.8417,N,02141.1700,E,0.00,351.76,210817,,,A*7C
GPS fix received.
Data is current.
Current time set from GPS time:
17/08/21,19:39:09+00
gsm_set_time() started
Modem Reply:

Modem Reply:
OK

gsm_set_time() completed

GPS already available, breaking
collect_gps_data(): fix acquired
Failed checksums:
4
collect_all_data() completed
Current:
17/08/21,19:39:08+00[210817,19390900,61.180695,21.686167,0.00,34.00,351.76,71,15]

gsm_send_at() started
Modem Reply:

OK

Modem Reply:

OK

Modem Reply:

OK

Modem Reply:

OK

Modem Reply:

OK

gsm_send_at() completed
0
gsm_disconnect() started
Modem Reply:

Modem Reply:
ERROR

gsm_disconnect() completed
gsm_connect() started
gsm_get_modem_status() started
Modem Reply:

Modem Reply:
+CPAS: 0

Modem Reply:

Modem Reply:
OK

gsm_get_modem_status() returned:
0
gsm_get_connection_status() started
Modem Reply:

Modem Reply:
+CME ERROR: 4

gsm_get_connection_status() returned:
-1
Modem Reply:

Modem Reply:
ERROR

Connecting to remote server...
0
Modem Reply:

Modem Reply:
ERROR

Can not connect to remote server:
updates.geolink.io
Modem Reply:

Modem Reply:
+CEER: "No report available"

Modem Reply:

Modem Reply:
OK

gsm_get_modem_status() started
Modem Reply:

Modem Reply:
+CPAS: 0

Modem Reply:

Modem Reply:
OK

gsm_get_modem_status() returned:
0
gsm_get_connection_status() started
Modem Reply:

Modem Reply:
+CME ERROR: 4

gsm_get_connection_status() returned:
-1
Modem Reply:

Modem Reply:
ERROR

Connecting to remote server...
1
Modem Reply:

Modem Reply:
ERROR

Can not connect to remote server:
updates.geolink.io
Modem Reply:

Modem Reply:
+CEER: "No report available"

Modem Reply:

Modem Reply:
OK

gsm_get_modem_status() started
Modem Reply:

Modem Reply:
+CPAS: 0

Modem Reply:

Modem Reply:
OK

gsm_get_modem_status() returned:
0
gsm_get_connection_status() started
Modem Reply:

Modem Reply:
+CME ERROR: 4

gsm_get_connection_status() returned:
-1
Modem Reply:

Modem Reply:
ERROR

Connecting to remote server...
2
Modem Reply:

Modem Reply:
ERROR

Can not connect to remote server:
updates.geolink.io
Modem Reply:

Modem Reply:
+CEER: "No report available"

Modem Reply:

Modem Reply:
OK

gsm_connect() completed
gsm_disconnect() started
Modem Reply:

Modem Reply:
ERROR

gsm_disconnect() completed
Error, can not send data or no connection.
Can not send data, saving to flash memory
storage_save_current() started
storage_save_current() ended
storage_send_logs() started
storage_send_logs(): Found log sent position:
1024
storage_send_logs(): Sending data from:
1024
Log data:
17/08/21,19:37:00+12[210817,19370100,61.180695,21.686167,0.00,34.00,351.76,71,15]

gsm_send_at() started
Modem Reply:

OK

Modem Reply:

OK

Modem Reply:

OK

Modem Reply:

OK

Modem Reply:

OK

gsm_send_at() completed
0
gsm_disconnect() started
Modem Reply:

Modem Reply:
ERROR

gsm_disconnect() completed
gsm_connect() started
gsm_get_modem_status() started
Modem Reply:

Modem Reply:
+CPAS: 0

Modem Reply:

Modem Reply:
OK

gsm_get_modem_status() returned:
0
gsm_get_connection_status() started
Modem Reply:

Modem Reply:
+CME ERROR: 4

gsm_get_connection_status() returned:
-1
Modem Reply:

Modem Reply:
ERROR

Connecting to remote server...
0
Modem Reply:

Modem Reply:
ERROR

Can not connect to remote server:
updates.geolink.io
Modem Reply:

Modem Reply:
+CEER: "No report available"

Modem Reply:

Modem Reply:
OK

gsm_get_modem_status() started
Modem Reply:

Modem Reply:
+CPAS: 0

Modem Reply:

Modem Reply:
OK

gsm_get_modem_status() returned:
0
gsm_get_connection_status() started
Modem Reply:

Modem Reply:
+CME ERROR: 4

gsm_get_connection_status() returned:
-1
Modem Reply:

Modem Reply:
ERROR

Connecting to remote server...
1
Modem Reply:

Modem Reply:
ERROR

Can not connect to remote server:
updates.geolink.io
Modem Reply:

Modem Reply:
+CEER: "No report available"

Modem Reply:

Modem Reply:
OK

gsm_get_modem_status() started
Modem Reply:

Modem Reply:
+CPAS: 0

Modem Reply:

Modem Reply:
OK

gsm_get_modem_status() returned:
0
gsm_get_connection_status() started
Modem Reply:

Modem Reply:
+CME ERROR: 4

gsm_get_connection_status() returned:
-1
Modem Reply:

Modem Reply:
ERROR

Connecting to remote server...
2
Modem Reply:

Modem Reply:
ERROR

Can not connect to remote server:
updates.geolink.io
Modem Reply:

Modem Reply:
+CEER: "No report available"

Modem Reply:

Modem Reply:
OK

gsm_connect() completed
gsm_disconnect() started
Modem Reply:

Modem Reply:
ERROR

gsm_disconnect() completed
Error, can not send data or no connection.
storage_send_logs(): Error sending logs
storage_send_logs() ended
Sleeping for:
-117842
ms
Error: negative sleep time.
sms_check() started
Modem Reply:

Modem Reply:
OK

Warning: timed out waiting for last modem reply
Deleting READ and SENT SMS
Modem Reply:

Modem Reply:
ERROR

Modem Reply:

Modem Reply:
ERROR

sms_check() completed
Ignition status:
0
Ignition is ON!
collect_all_data() started
gsm_get_time() started
Modem Reply:

+CCLK: "17/08/21,19:41:16+00"

OK

gsm_get_time() result:
17/08/21,19:41:16+00
gsm_get_time() completed
$GPVTG,351.76,T,,M,0.00,N,0.00,K,A*3B
$GPGGA,193909.000,6110.8417,N,02141.1700,E,1,14,0.73,34.0,M,21.1,M,,*5F
GPS fix received.
Warning: this fix date/time already logged, retrying

$GNGSA,A,3,03,06,26,22,31,02,29,23,09,,,,1.08,0.73,0.80*1B
$GNGSA,A,3,87,71,79,80,86,,,,,,,,1.08,0.73,0.80*18
$GPGSV,3,1,12,23,75,121,29,09,026,24,068,33,16,15,097,20,07,15,189,22*76
$GPGSV,3,3,12,29,10,005,32,22,10,130,24,31,10,037,26,49,,,*4F
$GLGSV,3,1,10,70,78,091,,71,45,287,35,80,43,132,21,79,40,042,21*69
$GLGSV,3,2,10,86,31,269,39,87,28,337,38,69,20,103,,73,06,167,*6A
$GLGSV,3,3,10,85,02,225,,88,01,014,*6A
$GNGLL,6110.8417,N,02141.1700,E,194116.000,A,A*41
$GNRMC,194117.000,A,6110.8417,N,02141.1700,E,0.00,351.76,210817,,,A*7C
GPS fix received.
Data is current.
Current time set from GPS time:
17/08/21,19:41:17+00
gsm_set_time() started
Modem Reply:

Modem Reply:
OK

gsm_set_time() completed

GPS already available, breaking
collect_gps_data(): fix acquired
Failed checksums:
5
collect_all_data() completed
Current:
17/08/21,19:41:16+00[210817,19411700,61.180695,21.686167,0.00,34.00,351.76,73,14]

gsm_send_at() started
Modem Reply:

OK

Modem Reply:

OK

Modem Reply:

OK

Modem Reply:

OK

Modem Reply:

OK

gsm_send_at() completed
0
gsm_disconnect() started
Modem Reply:

Modem Reply:
ERROR

gsm_disconnect() completed
gsm_connect() started
gsm_get_modem_status() started
Modem Reply:

Modem Reply:
+CPAS: 0

Modem Reply:

Modem Reply:
OK

gsm_get_modem_status() returned:
0
gsm_get_connection_status() started
Modem Reply:

Modem Reply:
+CME ERROR: 4

gsm_get_connection_status() returned:
-1
Modem Reply:

Modem Reply:
ERROR

Connecting to remote server...
0
Modem Reply:

Modem Reply:
ERROR

Can not connect to remote server:
updates.geolink.io
Modem Reply:

Modem Reply:
+CEER: "No report available"

Modem Reply:

Modem Reply:
OK

gsm_get_modem_status() started
Modem Reply:

Modem Reply:
+CPAS: 0

Modem Reply:

Modem Reply:
OK

gsm_get_modem_status() returned:
0
gsm_get_connection_status() started
Modem Reply:

Modem Reply:
+CME ERROR: 4

gsm_get_connection_status() returned:
-1
Modem Reply:

Modem Reply:
ERROR

Connecting to remote server...
1
Modem Reply:

Modem Reply:
ERROR

Can not connect to remote server:
updates.geolink.io
Modem Reply:

Modem Reply:
+CEER: "No report available"

Modem Reply:

Modem Reply:
OK

gsm_get_modem_status() started
Modem Reply:

Modem Reply:
+CPAS: 0

Modem Reply:

Modem Reply:
OK

gsm_get_modem_status() returned:
0
gsm_get_connection_status() started
Modem Reply:

Modem Reply:
+CME ERROR: 4

gsm_get_connection_status() returned:
-1
Modem Reply:

Modem Reply:
ERROR

Connecting to remote server...
2
Modem Reply:

Modem Reply:
ERROR

Can not connect to remote server:
updates.geolink.io
Modem Reply:

Modem Reply:
+CEER: "No report available"

Modem Reply:

Modem Reply:
OK

gsm_connect() completed
gsm_disconnect() started
Modem Reply:

Modem Reply:
ERROR

gsm_disconnect() completed
Error, can not send data or no connection.
Can not send data, saving to flash memory
storage_save_current() started
storage_save_current() ended
storage_send_logs() started
storage_send_logs(): Found log sent position:
1024
storage_send_logs(): Sending data from:
1024
Log data:
17/08/21,19:37:00+12[210817,19370100,61.180695,21.686167,0.00,34.00,351.76,71,15]

gsm_send_at() started
Modem Reply:

OK

Modem Reply:

OK

Modem Reply:

OK

Modem Reply:

OK

Modem Reply:

OK

gsm_send_at() completed
0
gsm_disconnect() started
Modem Reply:

Modem Reply:
ERROR

gsm_disconnect() completed
gsm_connect() started
gsm_get_modem_status() started
Modem Reply:

Modem Reply:
+CPAS: 0

Modem Reply:

Modem Reply:
OK

gsm_get_modem_status() returned:
0
gsm_get_connection_status() started
Modem Reply:

Modem Reply:
+CME ERROR: 4

gsm_get_connection_status() returned:
-1
Modem Reply:

Modem Reply:
ERROR

Connecting to remote server...
0
Modem Reply:

Modem Reply:
ERROR

Can not connect to remote server:
updates.geolink.io
Modem Reply:

Modem Reply:
+CEER: "No report available"

Modem Reply:

Modem Reply:
OK

gsm_get_modem_status() started
Modem Reply:

Modem Reply:
+CPAS: 0

Modem Reply:

Modem Reply:
OK

gsm_get_modem_status() returned:
0
gsm_get_connection_status() started
Modem Reply:

Modem Reply:
+CME ERROR: 4

gsm_get_connection_status() returned:
-1
Modem Reply:

Modem Reply:
ERROR

Connecting to remote server...
1
Modem Reply:

Modem Reply:
ERROR

Can not connect to remote server:
updates.geolink.io
Modem Reply:

Modem Reply:
+CEER: "No report available"

Modem Reply:

Modem Reply:
OK

gsm_get_modem_status() started
Modem Reply:

Modem Reply:
+CPAS: 0

Modem Reply:

Modem Reply:
OK

gsm_get_modem_status() returned:
0
gsm_get_connection_status() started
Modem Reply:

Modem Reply:
+CME ERROR: 4

gsm_get_connection_status() returned:
-1
Modem Reply:

Modem Reply:
ERROR

Connecting to remote server...
2
Modem Reply:

Modem Reply:
ERROR

Can not connect to remote server:
updates.geolink.io
Modem Reply:

Modem Reply:
+CEER: "No report available"

Modem Reply:

Modem Reply:
OK

gsm_connect() completed
gsm_disconnect() started
Modem Reply:

Modem Reply:
ERROR

gsm_disconnect() completed
Error, can not send data or no connection.
storage_send_logs(): Error sending logs
storage_send_logs() ended
Sleeping for:
-117950
ms
Error: negative sleep time.
sms_check() started
Modem Reply:

Modem Reply:
OK

Warning: timed out waiting for last modem reply
Deleting READ and SENT SMS
Modem Reply:

Modem Reply:
ERROR

Modem Reply:

Modem Reply:
ERROR

sms_check() completed
Ignition status:
0
Ignition is ON!
collect_all_data() started
gsm_get_time() started
Modem Reply:

+CCLK: "17/08/21,19:43:24+00"

OK

gsm_get_time() result:
17/08/21,19:43:24+00
gsm_get_time() completed
$GPVTG,351.76,T,,M,0.00,N,0.00,K,A*3B
$GPGGA,194117.000,6110.8417,N,02141.1700,E,1,14,0.78,34.0,M,21.1,M,,*54
GPS fix received.
Warning: this fix date/time already logged, retrying

$GNGSA,A,3,03,06,26,22,31,02,29,23,09,,,,1.52,0.78,1.31*14
$GNGSA,A,3,87,71,79,80,86,,,,,,,,1.52,0.78,1.31*17
$GPGSV,3,1,12,23,74,118,35,09,0,28*7A
$GPGSV,3,2,12,02,30,310,38,26,24,067,33,07,16,189,20,16,15,096,27*7B
$GPGSV,3,3,12,29,10,004,32,22,09,130,14,31,09,036,18,51,,,*48
$GLGSV,3,1,10,70,77,092,22,71,46,288,36,80,44,131,19,79,39,041,23*6A
$GLGSV,3,2,10,86,31,268,38,87,29,335,31,69,19,103,17,73,06,167,*6C
$GLGSV,3,3,10,88,02,014,,85,01,224,*6B
$GNGLL,6110.8417,N,02141.1700,E,194324.000,A,A*42
$GNRMC,194325.000,A,6110.8417,N,02141.1700,E,0.00,351.76,210817,,,A*7F
GPS fix received.
Data is current.
Current time set from GPS time:
17/08/21,19:43:25+00
gsm_set_time() started
Modem Reply:

Modem Reply:
OK

gsm_set_time() completed

GPS already available, breaking
collect_gps_data(): fix acquired
Failed checksums:
6
collect_all_data() completed
Current:
17/08/21,19:43:24+00[210817,19432500,61.180695,21.686167,0.00,34.00,351.76,78,14]

gsm_send_at() started
Modem Reply:

OK

Modem Reply:

OK

Modem Reply:

OK

Modem Reply:

OK

Modem Reply:

OK

gsm_send_at() completed
0
gsm_disconnect() started
Modem Reply:

Modem Reply:
ERROR

gsm_disconnect() completed
gsm_connect() started
gsm_get_modem_status() started
Modem Reply:

Modem Reply:
+CPAS: 0

Modem Reply:

Modem Reply:
OK

gsm_get_modem_status() returned:
0
gsm_get_connection_status() started
Modem Reply:

Modem Reply:
+CME ERROR: 4

gsm_get_connection_status() returned:
-1
Modem Reply:

Modem Reply:
ERROR

Connecting to remote server...
0
Modem Reply:

Modem Reply:
ERROR

Can not connect to remote server:
updates.geolink.io
Modem Reply:

Modem Reply:
+CEER: "No report available"

Modem Reply:

Modem Reply:
OK

gsm_get_modem_status() started
Modem Reply:

Modem Reply:
+CPAS: 0

Modem Reply:

Modem Reply:
OK

gsm_get_modem_status() returned:
0
gsm_get_connection_status() started
Modem Reply:

Modem Reply:
+CME ERROR: 4

gsm_get_connection_status() returned:
-1
Modem Reply:

Modem Reply:
ERROR

Connecting to remote server...
1
Modem Reply:

Modem Reply:
ERROR

Can not connect to remote server:
updates.geolink.io
Modem Reply:

Modem Reply:
+CEER: "No report available"

Modem Reply:

Modem Reply:
OK

gsm_get_modem_status() started
Modem Reply:

Modem Reply:
+CPAS: 0

Modem Reply:

Modem Reply:
OK

gsm_get_modem_status() returned:
0
gsm_get_connection_status() started
Modem Reply:

Modem Reply:
+CME ERROR: 4

gsm_get_connection_status() returned:
-1
Modem Reply:

Modem Reply:
ERROR

Connecting to remote server...
2
Modem Reply:

Modem Reply:
ERROR

Can not connect to remote server:
updates.geolink.io
Modem Reply:

Modem Reply:
+CEER: "No report available"

Modem Reply:

Modem Reply:
OK

gsm_connect() completed
gsm_disconnect() started
Modem Reply:

Modem Reply:
ERROR

gsm_disconnect() completed
Error, can not send data or no connection.
Can not send data, saving to flash memory
storage_save_current() started
storage_save_current() ended
storage_send_logs() started
storage_send_logs(): Found log sent position:
1024
storage_send_logs(): Sending data from:
1024
Log data:
17/08/21,19:37:00+12[210817,19370100,61.180695,21.686167,0.00,34.00,351.76,71,15]

gsm_send_at() started
Modem Reply:

OK

Modem Reply:

OK

Modem Reply:

OK

Modem Reply:

OK

Modem Reply:

OK

gsm_send_at() completed
0
gsm_disconnect() started
Modem Reply:

Modem Reply:
ERROR

gsm_disconnect() completed
gsm_connect() started
gsm_get_modem_status() started
Modem Reply:

Modem Reply:
+CPAS: 0

Modem Reply:

Modem Reply:
OK

gsm_get_modem_status() returned:
0
gsm_get_connection_status() started
Modem Reply:

Modem Reply:
+CME ERROR: 4

gsm_get_connection_status() returned:
-1
Modem Reply:

Modem Reply:
ERROR

Connecting to remote server...
0
Modem Reply:

Modem Reply:
ERROR

Can not connect to remote server:
updates.geolink.io
Modem Reply:

Modem Reply:
+CEER: "No report available"

Modem Reply:

Modem Reply:
OK

gsm_get_modem_status() started
Modem Reply:

Modem Reply:
+CPAS: 0

Modem Reply:

Modem Reply:
OK

gsm_get_modem_status() returned:
0
gsm_get_connection_status() started
Modem Reply:

Modem Reply:
+CME ERROR: 4

gsm_get_connection_status() returned:
-1
Modem Reply:

Modem Reply:
ERROR

Connecting to remote server...
1
Modem Reply:

Modem Reply:
ERROR

Can not connect to remote server:
updates.geolink.io
Modem Reply:

Modem Reply:
+CEER: "No report available"

Modem Reply:

Modem Reply:
OK

gsm_get_modem_status() started
Modem Reply:

Modem Reply:
+CPAS: 0

Modem Reply:

Modem Reply:
OK

gsm_get_modem_status() returned:
0
gsm_get_connection_status() started
Modem Reply:

Modem Reply:
+CME ERROR: 4

gsm_get_connection_status() returned:
-1
Modem Reply:

Modem Reply:
ERROR

Connecting to remote server...
2
Modem Reply:

Modem Reply:
ERROR

Can not connect to remote server:
updates.geolink.io
Modem Reply:

Modem Reply:
+CEER: "No report available"

Modem Reply:

Modem Reply:
OK

gsm_connect() completed
gsm_disconnect()
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

Thread 76 (2019-01-27):

no updates are sent

Chrescht, 2019-01-27:
Hi there,

my issue is I can't see any updates on the live map.
I did set the APN by sms command, also finally got to see the tracker's debug messages, and one of them is talking about a wrong key. What key would that be?

Also:
- how do I remove a "unit" on mydomain.geolink.io?
- what is the "remote key"? You don't talk about it in your startup guide (https://geolink.io/guide.php)
- how do I check the currently installed opentracker software version?
- how would I go about updating it?

I'd be really happy to get this sorted out.

ps: I have no debug file available now, but I can send it later.

opensourcegps, 2019-01-27:
Hi Chrescht,

please check your unit key under Units -> [Your unit] -> Options -> Remote Key.

It must match the key set in firmware (tracker.h):

```
#define KEY "cSQ88qShwC3"
```
You can delete units under Settings -> Branding -> Allowed IMEI
You can update firmware via Adruino IDE.

I hope this helps.

Chrescht, 2019-01-27:
Thanks for your fast answer.
I got the opentracker because it's supposed to work more or less out of the box with geolink.
- how come there is no mention at all about that key?
- is there no way to set that key with an sms command?
- latest version seems to be 3.2.0, but nowhere can I see how to update the firmware. It's probably only a couple of manipulations using the IDE but come on guys, just include a quick manual for the less experienced

opensourcegps, 2019-01-27:
It normally works out of the box. The key is saved on the first connect from the tracker. So it's not required to deal with it. It is there to add additional security to your data and to make sure data is received from your device.

It is strange that you got key saved differently, could be that you made some manual requests for your IMEI number or key mismatch just happened by itself?

In case you are using default firmware, simply set key in the web interface:

```
Units -> [Your unit] -> Options -> Remote Key.
```
to

```
cSQ88qShwC3
```

Please check our user guide for full tracker manual: https://github.com/geolink/opentracker/blob/master/docs/OpenTracker%202.4%20User%20Manual%201.4.pdf

Chrescht, 2019-01-28:
Thanks, will try.
Other new issue: I get no response at all from the board, I was using another power source, 18V. No LEDs, nothing..how can I check if it is definitely dead?
Nowhere does it seem to have overheated, at least not visible to the naked eye.

m4rkw, 2019-01-28:
@Chrescht 18V shouldn't have killed it, max on the spec is 32V. Is it recognised when connected via USB?

Chrescht, 2019-01-28:
Success, thanks guys! First I tried method 2, no success, but the first reset method seemed to have done the trick, I set remote key in tracker.h, uploaded the current firmware, set the APN by sms, then finally saw the correct GPS position in the LIVE map.
If I could I'd buy you a  🍺

Closed 2019-01-30.

Thread 79 (2019-01-31):

geolink.io: trips not finalized when car stops

Chrescht, 2019-01-31:
My trip from this morning was got connected to some older trip from two days ago. That's not good.
Is there a way to define when to start a new trip? Something like setting the off time interval.

I got many undefined points:
Speed: undefined km/h
Altitude: undefined m
Heading: undefined

The ignition cable is connected. Do you have an idea what the issue here could be?

m4rkw, 2019-01-31:
Hi @Chrescht I don't speak for Geolink but I think stuff like this (ie problems with the service you're paying for) should probably be dealt with by their support rather than by opening github issues. Try emailing support@geolink.io

Chrescht, 2019-02-13:
Which of the 16 OBD2 pins is the VDET (IGN) one to determine if the car is running? I can't seem to find this information anywhere.

geolink support: they are flooded by emails apparently so you won't get an answer anytime soon.

Chrescht, 2019-08-10:
@m4rkw thanks for your reply, I did ask them, not much came back though.
I can answer my car running question now: at least for VW cars it's pin 1 on the OBD2, (12V when key in the last positions, else 0V).

At the moment the trip A->B gets saved 3 times for some reason, and the trip B->A is missing.. I'll have to do some debugging.
