geolink/opentracker/docs/OpenTracker 2.4 Dimensions.pdf

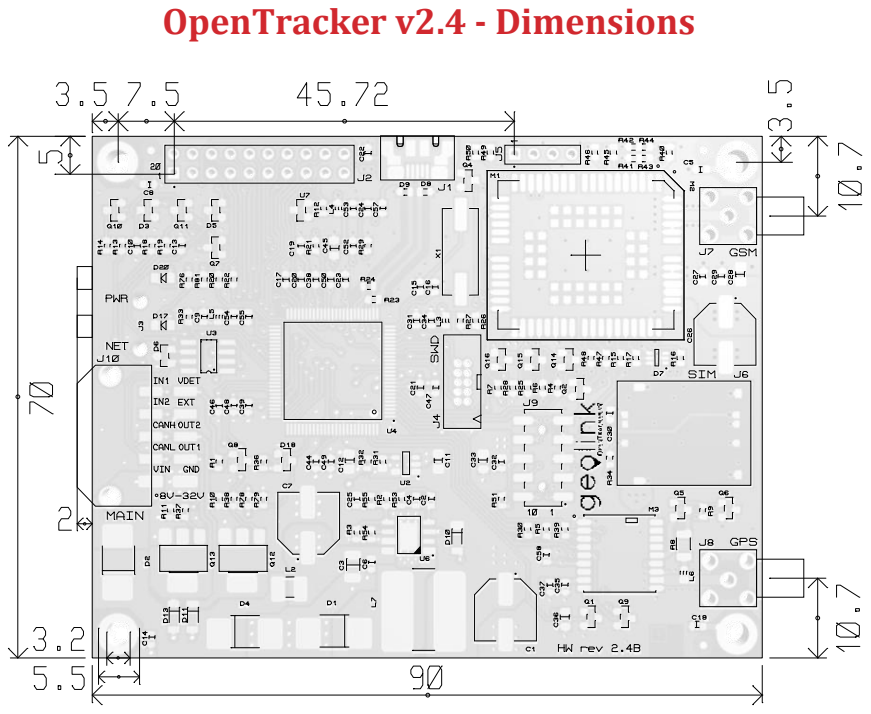
[picture p74: page 1]
OpenTracker v2.4 - Dimensions
