geolink/opentracker/(list of files, drawings)

Other design files:
pcb/Proteus Project Files/OpenTracker_2.pdsprj
