geolink/opentracker/OpenTracker/reboot.ino

void reboot() {
  debug_print(F("reboot() started"));

  //reset GPS
  gps_off();
  //emergency power off GSM
  gsm_off(1);

  //disable USB to allow reboot
  //serial monitor on the PC won't work anymore if you don't close it before reset completes
  //otherwise, close the serial monitor, detach the USB cable and connect it again

  // debug_port.end() does nothing, manually disable USB
  UDD_Detach(); // detach from Host

  cpu_irq_disable();
  rstc_start_software_reset(RSTC);
  for (;;)
  {
    // If we do not keep the watchdog happy and it times out during this wait,
    // the reset reason will be wrong when the board starts the next time around.
    WDT_Restart(WDT);
  }
}

void usb_console_disable() {
  cpu_irq_disable();
  
  // debug_port.end() does nothing, manually disable USB serial console
  UDD_Detach(); // detach from Host
  // de-init procedure (reverses UDD_Init)
  otg_freeze_clock();
  otg_disable_pad();
  otg_disable();
  pmc_disable_udpck();
  pmc_disable_upll_clock();
  pmc_disable_periph_clk(ID_UOTGHS);
  NVIC_DisableIRQ((IRQn_Type) ID_UOTGHS);
  NVIC_ClearPendingIRQ((IRQn_Type) ID_UOTGHS);

  cpu_irq_enable();
}

void usb_console_restore() {
  if (!Is_otg_enabled()) {
    // re-initialize USB
    UDD_Init();
    UDD_Attach();
  }
}

// override for lower power consumption (wait for interrupt)
void yield(void) {
  pmc_enable_sleepmode(0);
}

void cpu_slow_down() {
  addon_event(ON_CLOCK_PAUSE);

  SysTick->CTRL &= ~SysTick_CTRL_TICKINT_Msk; // temp disable interrupt
  
  // slow down CPU
  pmc_mck_set_prescaler(PMC_MCKR_PRES_CLK_64); // master clock prescaler

  // update timer settings
  SystemCoreClockUpdate();
  SysTick_Config(SystemCoreClock / 1000);

  addon_event(ON_CLOCK_RESUME);
}

void cpu_full_speed() {
  addon_event(ON_CLOCK_PAUSE);

  // re-init clocks to full speed
  SystemInit();
  SysTick_Config(SystemCoreClock / 1000);

  addon_event(ON_CLOCK_RESUME);
}

void enter_low_power() {
  debug_print(F("enter_low_power() started"));

  addon_event(ON_DEVICE_STANDBY);

  // enter standby/sleep mode

  gps_standby();
  gps_close();

  gsm_standby();
  gsm_close();

  cpu_slow_down();
  
  debug_print(F("enter_low_power() completed"));
}

void exit_low_power() {
  debug_print(F("exit_low_power() started"));

  cpu_full_speed();
  
  // enable serial ports
  gsm_open();
  gsm_wakeup();

  gps_open();
  gps_wakeup();

  addon_event(ON_DEVICE_WAKEUP);

  debug_print(F("exit_low_power() completed"));
}

void kill_power() {
  debug_print(F("kill_power() called"));
  addon_event(ON_DEVICE_KILL);
  // save as much power as possible
  gps_off();
  gps_close();
  gsm_off(1);
  gsm_close();
  usb_console_disable();
  // slow down cpu even more
  pmc_switch_mainck_to_fastrc(CKGR_MOR_MOSCRCF_4_MHz);
  cpu_slow_down();
  cpu_irq_disable();
  // turn off LED and CAN
  digitalWrite(PIN_POWER_LED, HIGH);
  pinMode(PIN_CAN_RS, OUTPUT);
  digitalWrite(PIN_CAN_RS, HIGH);
  // disable peripherals and use wait mode
  pmc_set_writeprotect(0);
  pmc_disable_all_periph_clk();
  pmc_enable_waitmode();
  for(;;) // freeze in low power mode
  reboot();
}
