geolink/opentracker/(commit log)

2015-03-17 pcb files
    [OpenTracker_2.pdsprj]
2015-05-09 always on, since power draw is only 0.11A when transmitting.
2015-05-09 append battery voltage level to the data packet.
2015-05-09 added "locate" command that replies with a google maps url with the current location.
2015-05-09 added option to reboot after n gsm send failures (because sometimes the gsm module seems to just die :/)
    [gsm.ino, tracker.h]
2015-05-09 made it possible (and default) to disable the gsm failure reboot threshold.
    [gsm.ino]
2015-05-09 made battery level, ignition state and engine running time configurable for inclusion in the POST string.
2015-05-18 updated board variant to use chip SAM3A4C
2015-05-31 using delay() after modem commands is not good practice, so replaced them with a routine that checks for the final response from the modem. (when running in fast-as-possible mode with RAW sending, th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
    [gsm.ino, parse.ino, sms.ino, storage.ino]
2015-05-31 fixed sms commands after changes to remove delay()s
    [gsm.ino, sms.ino]
2015-06-24 added note for new development of IDE integration
    The latest Arduino IDEs have a Boards Manager that can automatically download and install the required files to support a new target board.
2015-07-08 fixed bug where the modem_reply buffer is overwritten after retrieving the imei from the modem.
    [gsm.ino]
2015-07-08 fixed buffer bug when retrieving the IMEI number.
    [gsm.ino, parse.ino, reboot.ino, storage.ino]
2015-07-08 reverted previous gps time/date patch (testing)
    [gps.ino]
2015-07-09 added fullBuffer flag to gsm_wait_for_reply function so that calls which require the whole buffer can still get the correct data.
    [gsm.ino, parse.ino, sms.ino]
2015-07-09 fixed formatting of gps data in the packet and added ievans gps date/time fix back in.
    [gps.ino]
2015-07-09 fixed data packet formatting
    [gps.ino]
2015-07-18 fixed a bug in the formation of the data packet when running in raw mode
    [data.ino]
2015-07-18 fixed bug causing the #eof to not be detected when running in http mode.
    [gsm.ino]
2015-07-23 hopefully fixing http bug
    [gsm.ino, parse.ino]
2015-07-23 Added option GSM_STAY_ONLINE so that the data session continues indefinitely instead of disconnecting the data session after each send of data.
    It came about as my provider charges for data sessions in 25K blocks but it used to be 1MB blocks.
2015-07-28 Moved out hardware files to separate repository
    [OpenTracker_2.pdsprj]
2015-07-29 improved GSM on/off procedure (and minor fix)
    make sure we use calculated HTTP content length string
    [gsm.ino]
2015-07-29 removed wait after power off (no longer needed)
    [gsm.ino]
2015-09-08 added ability to differentiate between the ignition and the engine running by setting a sensible voltage threshold, eg 12V.
2016-02-02 led pipe doc and release notice
2016-03-29 fixed compilation warnings and typos
    [settings.ino]
2016-03-30 use less restrictive check for headers (not yet perfect)
    there are too many assumptions that may lead to failure in detecting HTTP headers
    this fix can cope with server replies that don't have "Connection: close" as the last header line
    [parse.ino]
2016-03-30 added board dimensional drawings
2016-03-30 defined addon interface for expansion boards and additional features
2016-03-31 fixed data send procedure and ack validation
    [gsm.ino, parse.ino]
2016-03-31 reworked modem setup procedure and power on/off
    [gsm.ino]
2016-03-31 reworked GPS setup and power on/off
    [gps.ino]
2016-03-31 changed "hard" reboot to "soft" reboot (kill external hw and reset mcu)
    [reboot.ino]
2016-03-31 implemented low power mode entry/exit
2016-04-01 changed low power mode entry/exit and fixed event notifications
    [addon.h, reboot.ino]
2016-04-04 testing low power mode (disabled by default)
2016-04-04 added open/close functions for GSM/GPS (for low power mode)
2016-04-04 fixed phone number handling in SMS, fixed alarm command
    [sms.ino]
2016-04-04 fixed PIN configuration at startup
    [gsm.ino]
2016-04-04 fixed conditional compilation for STORAGE option
    [data.ino]
2016-04-05 improved send data function, with error checking
    [gsm.ino]
2016-04-05 added example implementation of addon board functions
2016-04-06 fixed get modem status
    [gsm.ino]
2016-04-06 fixed long wait on first PIN check
    [gsm.ino]
2016-04-06 replaced strncpy with safer strlcpy
    [storage.ino]
2016-04-06 fixed missing loading of PIN settings
    [settings.ino]
2016-04-06 fixed PIN procedure again, now checking errors
    [gsm.ino]
2016-04-06 fixed use of gsm_send_at()
    [gsm.ino]
2016-04-06 fixed addon event on settings save
    [settings.ino]
2016-04-06 fixed SMS parsing issues (buffer overwritten)
    [sms.ino]
2016-04-07 prevent data connection if modem status not ready
    [gsm.ino]
2016-04-07 allow logging unknown ignition state (backup power source)
2016-04-07 improved modem power on and auto-baudrate
2016-04-07 fixed buffer overrun with unexpected long server replies
    [parse.ino]
2016-06-09 removed old board support files, now in geolink/opentracker-arduino-board
2016-06-09 reboot pin not used anymore, initialized only if present
    [OpenTracker.ino]
2016-06-09 fixed initialization of settings, better string copy
    [settings.ino]
2016-06-09 fixed buffer length for time string
    added also some debug for storage
    [OpenTracker.ino]
2016-06-09 fixed warning for using uninitialized vars
    [sms.ino]
2016-06-09 fixed storage_dump() for debug
    [storage.ino]
2016-06-09 fixed warnings for unused vars
    [parse.ino]
2016-06-14 fixed gsm_get_reply, could hang if saturating receive buffer
    also improved reading from the serial port, allowing some
    inter-character delay before giving up
    [gsm.ino]
2016-06-14 improved SMS check, fixed buffer handling, lower delay
    [sms.ino]
2016-06-14 removed reboot after some SMS commands
    [sms.ino]
2016-06-15 improved connection flow (see Quectel TCPIP appnote)
2016-06-27 enable data connection interruptible by voice call
2016-06-27 fixed using safe functions for data buffer
    [data.ino]
2016-06-27 fixed connection logic, in case of errors
    [gsm.ino]
2016-06-28 fixed status led, now updating during delays
    [OpenTracker.ino, addon.h, gps.ino, gsm.ino, led.ino, parse.ino, sms.ino]
2016-06-28 fixed SMS check with engine not running
    [OpenTracker.ino]
2016-06-28 fixed GPRS context activation if already active
    [gsm.ino]
2016-06-28 fixed delay function in addon sample
2016-06-28 moved reboot sooner after SMS check
    [OpenTracker.ino]
2016-06-28 fixed long wait on failed connection attempt
    [gsm.ino]
2016-07-18 fixed GSM (power) Status pin handling
    [gsm.ino]
2016-09-01 fixed update of GSM clock from GPS date and missing leading zeros in GPS date/time
    [gps.ino]
2016-09-08 fixed low power mode when USB not connected
    [reboot.ino]
2016-09-08 fix for USB deactivation/restore (needs current 1.0.4 board package)
    [reboot.ino]
2016-09-09 refactoring power save functions, adding CPU slow down
2016-09-15 fixed low power exit function
    [reboot.ino]
2016-09-15 added optional HTTP GET request method, added check for modem reply failures, some code clean up
    [OpenTracker.ino, data.ino, gsm.ino, sms.ino]
2016-09-16 changed wait for GPS fix using true timeout settings
    [gps.ino]
2016-09-16 implemented low power sleep in main loop
2016-09-19 improved modem replies (multi-line buffers handled correctly)
    [gsm.ino]
2016-09-20 fixed SMS command handling
    can now cope with multiple SMS to be read
    fixed missing SMS reply because of SMS listing still going on
    [sms.ino]
2016-09-21 more robust check of connection status (both socket and data link)
2016-09-21 fixed reading of SMS commands
    [sms.ino]
2016-10-04 fixed getting connection state on M95
    [gsm.ino]
2016-10-12 use GSM clock only after it has been set (don't use power-up date/time)
2016-10-26 quick fix for APN scan and 3G support
    [gsm.ino]
2016-11-03 fixed no modem echo at power up (3G)
    [gsm.ino]
2016-11-04 updated documentation for board revision 2.4
2016-11-09 added support for supply cut-off (lowest power consumption)
2017-03-06 fixed auto APN scan to use previous config instead of default when failing
    [gsm.ino]
2017-04-21 fixed typo in diagnostic message
    [gsm.ino]
2017-04-21 fixed URLs for location SMS
    [sms.ino]
2017-04-21 updated GPS data collection, fixed timeout, better validity check
    [gps.ino]
2017-04-21 added NTP synchronization for modem clock at reset
    [OpenTracker.ino, gsm.ino]
2017-04-21 enabled experimental QuecLocator to replace GPS when fix is not available (nsat=-1)
    [data.ino]
2017-04-21 fixed NTP command for 3G modem variant
    [gsm.ino]
2017-04-25 fixed GPS data collection could use old buffer
    [gps.ino]
2017-04-26 fixed QuecLocator option still visible when disabled
    [settings.ino]
2017-06-01 fixed gps "fix age" regression introduced with date/time patch
    [OpenTracker.ino, gps.ino]
2017-06-05 refactored battery voltage read, rewrote data append functions, fixed field separator in raw data packet
    [data.ino]
2017-06-05 changed powersave option (disable USB), added missing SMS command
    [OpenTracker.ino, sms.ino]
2017-06-07 fixed powersave mode
2017-06-07 fixed interval_count preventing data send at ignition turn-off
    [OpenTracker.ino]
2017-06-08 reworked SMS check to allow different rates based on ignition
    [OpenTracker.ino]
2017-06-08 added power saving with engine off
2017-06-08 changed powersave implementation, added debug command
